Tokoro0917/Mice-Standard/mechanical/README.md

# mechanical

Fusion 360 で設計した機構データです。

| ディレクトリ | 内容 |
| --- | --- |
| `cad/` | Fusion 360 のデータ（`.f3d` / `.f3z` でエクスポート）と STEP |
| `stl/` | 3D プリント用データ（STL / 3MF）。造形設定（材料・充填率・向き）は下表に記載 |
| `dxf/` | 切削・レーザー加工用データ |

Fusion 360 のデータはクラウドにあるため、更新したらエクスポートしたファイルをここにコミットしてください。

## 3D プリント部品

機構部品は基本的に 3D プリンタで製作します。

- プリンタ: Bambu Lab（ノズル 0.4 mm）
- 材料: PLA
- 配布形式: STL と、造形設定込みの Bambu Studio 用 3MF
- 1 部品は 180 × 180 × 180 mm 以内（A1 mini 対応）

| 部品 | ファイル | 材料 | 個数 | 造形の向き・メモ |
| --- | --- | --- | --- | --- |
| シャーシ | `stl/chassis.stl`（`cad/chassis.step`） | PLA | 1 | 後ろのはりの面を下にして印刷（前のはりは約 41 mm のブリッジ）。充填 30 % 以上、壁 3 周以上 |
| ホイール | TBD | PLA | 2 | 直径 47 mm（O リング込み、車高 2.5 mm） |
| タイヤ | — | O リング / シリコン（市販品） | 2 | ホイールの溝に装着 |
| 接地点 | — | カグスベール（市販品） | 2 | φ8 に切ってシャーシの台に貼る |

## 機体全体の STEP（v0.1、Fusion 360 への読み込み用）

`cad/mice-standard-assembly.step`: シャーシ・メイン基板・センサ基板 ×4・モータ ×2・ホイール ×2 を組み立てた参考モデル（`cad/assembly-iso.png`、`cad/assembly-rear.png`、`cad/assembly-bottom.png`）。

| 項目 | 値 |
| --- | --- |
| 座標 | X = 右、Y = 前、Z = 上。原点は車軸の真下の床 |
| 全体の大きさ | 幅 80 mm（車幅、メイン基板と横センサの LED の先）× 長さ 約 128 mm × 高さ 約 69 mm |
| 電池 | Zeee 3S 850 mAh 100C（67 × 30 × 18.5 mm、74 g）を後ろに立てて載せる（長い辺を左右、高さ 30 mm） |
| その場旋回の半径 | 約 76 mm（車軸の中心から一番遠い角まで。区画の中心から壁までは 84 mm） |
| 重心（見積もり） | 全体 約 395 g、車軸の約 10 mm 後ろ、床から約 27 mm（重さは仮の値） |
| 車高 | 2.5 mm（床からモータの底面まで） |
| ホイール | 直径 47 mm（O リング込み）、幅 6 mm、モータ軸の先端に付ける（仮） |
| モータ | PKP242D23A2（42 mm 角 × 17 mm、インロー φ22、軸 φ5 × 15 mm）を背中合わせ、すき間 1 mm |
| メイン基板 | 下面の高さ 48.5 mm（モータ上面との間 4 mm。部品の足のはみ出し用） |
| センサ基板 | メイン基板の下に垂れ下がる。差し込み部はメイン基板の上に 0.9 mm 出る。下端は床から約 18.5 mm |
| NUCLEO・MP6500 | 外形だけの仮の板（ピンソケットの上、高さ 8.5 mm） |

- 色付きの図（迷路の区画 180 mm の中に置いたところ）: `cad/render-iso.png`（前・左から）、`cad/render-rear.png`（後ろから）、`cad/render-top.png`（上から）、`cad/render-side.png`（横から）
- まだ入っていないもの: ねじ、電池のバンド
- 重心が車軸より後ろなので、後ろの接地点（電池の台の下のカグスベール）にいつも少し重さがかかる（約 2 割の見込み）。気になる場合は、基板に対してモータ（車軸）を後ろへずらす
- 作り直し方: 基板の STEP（`hardware/*/` の `.step`）を同じフォルダに `main.step`・`sensor.step` として置き、CadQuery で `python make_assembly.py <フォルダ> <出力.step>`。メイン基板の STEP は原点を車軸の真上（基板の x = 40 mm、y = 55 mm）にして出力する

## シャーシ v0.1（3D プリント、PLA 一体成形）

`cad/make_chassis.py`（CadQuery）で作成。`cad/chassis.step`（Fusion 360 用）、`stl/chassis.stl`（印刷用）、`cad/chassis-iso.png`。

| 部分 | 形 |
| --- | --- |
| モータ取付壁 ×2 | 厚さ 3 mm。モータの取付面に当て、インロー φ22 の穴（φ22.4）と M3 の穴 ×2（外側に座ぐり）で留める |
| 前後のはり | 左右の壁をつなぐ。上端は基板の 10 mm 下（部品の足をよける）。真ん中を肉抜きして配線を通す |
| ボス ×4 | メイン基板の取付穴 H1〜H4 の位置。M3 タッピングねじ用の下穴 φ2.6、深さ 10 mm |
| 前の腕と接地点 | 前のはりから伸ばした腕（幅 10 mm、上面は床から 9 mm でセンサ基板の下）。先の台（φ10）の下面にカグスベールを貼る。車軸の前 45 mm |
| 電池の台（後ろ） | 後ろのはりの後ろに、電池を**立てて**載せる台。床 1.5 mm、後ろの壁 高さ 20 mm、左右の壁 高さ 6 mm（線が出る側をふさがない）。床に面ファスナーのバンドを通す穴 ×2。床の下面にカグスベールを貼って後ろの接地点にする |

- 大きさ 72 × 117 × 47 mm、体積 約 33 cm³（充填 100 % で約 41 g）
- **下面はすべて床から 2.0 mm の平らな面**（印刷のベッド面）。カグスベール（1.5 mm）を貼る面も同じで、床とのすき間 0.5 mm。モータの底面は 2.5 mm
- **印刷は下面をベッドに置いて、そのまま立てて印刷**できる（はり・腕・電池の台・ボスはすべて下面から立ち上がる）
- 組み立てに使うねじ: モータ用 M3 × 6 低頭ねじ ×4、基板用 M3 タッピングねじ（長さ 8 mm 程度）×4
- **モータの向き**: モータのコネクタ（側面から 9 mm 出る）は**後ろ向き**にする。上向きだとメイン基板に当たる。M3 の穴の位置（対角のどちらか）は現物で確認して `MOTOR_HOLES` を合わせる
- **カグスベール**（ニチアス、フリーサイズ、厚さ 約 1.5 mm、KOGUMA-Mk4 と同じ）を φ8 に切って台の下面に貼る。床とのすき間は 約 0.5 mm。厚さは実物を測って `KAGU_T` を合わせる
- 要確認: 印刷して、インローと穴のはめ合い、接地点の高さ、全体の剛性を確かめる
