Tokoro0917/Mice-Standard/hardware/production/README.md

# production

基板発注用のデータと部品表（BOM）を置きます。

- [`bom.csv`](bom.csv) : 部品表（v0.1）
- `gerber/` : ガーバーデータ（設計後に追加）

## 部品表 v0.1 の概要

- 価格は 2026-11-09 時点の秋月電子通商・RobotShop の Web サイトの表示
- 「1 台あたり」はパック品を 1 個あたりに割った値。実際の購入はパック単位
- 部品は秋月で手に入るものの中で最も性能のよいものを選ぶ
- 部品の種類はできるだけ減らす（電子部品は 21 種類。抵抗 4 種類、コンデンサ 2 種類）
- 状態: **確定** / **要確認**（品番や在庫に確認が必要） / **未定**

### 1 台あたりの費用（概算）

| 項目 | 金額 |
| --- | --- |
| NUCLEO-L432KC | 2,800 円 |
| MP6500 デジタル電流制御版 ×2（RobotShop、送料別） | 3,914 円 |
| その他の電子部品（秋月） | 約 1,000 円 |
| モータ ×2 | 0 円（提供品） |
| **電子部品の合計** | **約 7,700 円** |
| 未定: LiPo 電池、基板、PLA、O リング、ねじ、ヒートシンク | — |

### 要確認・未定の項目

- ヒートシンク: 後で検討
- MP6500: RobotShop で取り寄せ（入荷待ち）。送料・税の扱いを確認する
- LiPo 電池、O リング、ねじ、基板の費用
