Tokoro0917/Mice-Standard/docs/spec.md

# 標準機 仕様書

> ステータス: **v0.1（検討中）**
> ✅ 決定　📝 案（未確定）　❓ 未定

## 設計方針

- 競技: **クラシック**（18 cm 区画）
- 対象: **プログラム初心者**。迷路を完走するまでを標準で用意する
- 製作: 基板はサークルで発注し、部員は**はんだ付けから**
- **表面実装部品（SMD）は使わない**。部品はリード部品（スルーホール）と、ピンヘッダで差し込むモジュールのみ
- 壊れやすい部品（マイコン・モータドライバ）は**差し替え可能**にする
- NUCLEO の改造は **SB16 / SB18 を外すことのみ**（表示 LED 用）
- 機構部品は**基本的に 3D プリンタで製作**する（データは `mechanical/` で公開）

## 構成部品

| 項目 | 部品 | 数量 | 状態 | 備考 |
| --- | --- | --- | --- | --- |
| モータ | オリエンタルモーター **PKP242D23A2**（ステッピングモータ、42 mm 角、バイポーラ） | 2 | ✅ | 詳細仕様は下表。ケーブル先端は XH コネクタ（メイン基板に XH 4P ポスト） |
| モータドライバ | Pololu **MP6500** キャリア（**デジタル電流制御版**、#2968） | 2 | ✅ | STEP/DIR 制御。モータ電源 4.5〜35 V、電流制限は I1 / I2 ピンで 0.5 / 1 / 1.5 / 2 A。RobotShop で購入。ヒートシンクは後で検討 |
| マイコン | NUCLEO-L432KC（STM32L432KC、Cortex-M4 80 MHz、Flash 256 KB、RAM 64 KB） | 1 | ✅ | サークルで使用実績あり。ST-LINK と USB シリアル付き。メイン基板のピンソケットに差し込み。秋月電子で購入可（2,800 円） |
| 駆動方式 | モータ軸にホイール直結（ギアなし） | — | 📝 | |
| 車輪 | 2 輪 + 前後の接地点（カグスベール） | — | ✅ | 詳細は「機構」を参照 |
| 壁センサ | 赤外 LED OSI5LA5A33A-B（秋月 113204）+ フォトトランジスタ L-51ROPT1D1（秋月 104211） | 4 組 | ✅ | 左右横 2 組 + 前 2 組。**センサ基板に実装**（下記） |
| ジャイロ (IMU) | なし | — | 📝 | 後付けする場合は I2C1（PA9 / PA10）を使う（[ピン割り当て](pin-assignment.md)） |
| 電池 | **Zeee Premium 3S 11.1 V 850 mAh 100C**（XT30、JST-XH バランス、67 × 30 × 18.5 mm、74 g） | 1 | ✅ | 約 2 A で約 25 分。機体の後ろに立てて載せる。XT30 のオス・メスは現物で確認して基板側を合わせる |
| 電源 | P-ch MOSFET 2SJ673-AZ（電源スイッチ、KOGUMA-Mk4 と同じ方式）、スライドスイッチ、9 V LDO BA90DD0T | 1 | ✅ | **電池電圧を直接使うのはモータのみ**。9 V は NUCLEO の VIN・赤外 LED・ブザー用。ロジック系は NUCLEO の 3.3 V。詳細は「電源構成」 |
| 操作・表示 | タクトスイッチ ×2、LED ×4、ブザー | — | ✅ | LED3 / LED4 のため NUCLEO の SB16 / SB18 を外す（[ピン割り当て](pin-assignment.md)） |
| 通信 | USB シリアル（NUCLEO 内蔵） | — | 📝 | ログ取り出し用 |

## モータ PKP242D23A2 の仕様

出典: オリエンタルモーター 製品ページ（2026-11-09 時点）

| 項目 | 値 |
| --- | --- |
| タイプ | 2 相、**薄型**、バイポーラ 4 本リード、片軸 |
| 取付角寸法 | 42 mm |
| 本体長さ（取付面から後端） | 17 mm |
| 励磁最大静止トルク | 0.1 N·m |
| ローター慣性モーメント | 13 × 10⁻⁷ kg·m² |
| 基本ステップ角 | 1.8°（200 ステップ/回転） |
| 定格電流 | 2.3 A/相 |
| 電圧 | 1.4 V |
| 巻線抵抗 | 0.61 Ω/相 |
| インダクタンス | 0.53 mH/相 |
| 質量 | 0.11 kg |
| 出力軸 | φ5 mm (h7)、取付面からの長さ 15 mm、D カット（幅 4.5 mm、長さ 10 mm） |
| インロー | φ22 mm (h7)、高さ 1.5 mm |
| 取付ねじ | M3 × 2 箇所（ピッチ 31 mm、深さ 4.5 mm） |
| コネクタ | 側面から約 9 mm 突出（接続ケーブル取付時）。ハウジング MDF97A-5S-3.5C（ヒロセ電機） |
| 価格 | 定価 6,000 円/個（**サークルでは提供品を使うため費用なし**） |

### 設計上の注意

- **コネクタが側面に 9 mm 出る**ため、下向きにすると床に当たる。モータは**コネクタが上向き**になる向きで取り付ける
- 取付ねじは 2 箇所（対角）のみ。シャーシ側は M3 ねじで固定し、インロー φ22 で位置決めする
- ホイールは軸の D カットに合わせた穴にして空転を防ぐ
- **脱調防止のため、定格 2.3 A に近い電流で駆動する**。MP6500 デジタル電流制御版の最大設定 **2 A** を使う。実機で発熱を確認する（ヒートシンクは後で検討）
- 定格付近ではモータ 1 個あたり約 6.5 W の発熱（2 相励磁時の計算値）。メーカー注意事項によりモータケース温度は 100 ℃ 以下とする。**停止中は励磁を切る / 電流を下げる**制御を入れる

## 部品選定の方針と注意点

電子部品は**できるだけ秋葉原（秋月電子通商）でそろえ、秋月で手に入るものの中で最も性能のよいものを選ぶ**（ただし LDO の出力コンデンサのように、回路が安定する範囲の中で選ぶ）。抵抗は**一般的な値（E6 系列: 10, 15, 22, 33, 47, 68 × 10ⁿ）**を使い、並列・直列の組み合わせで中途半端な値を作らない。

**部品の種類はできるだけ減らす**（同じ部品を使い回す）。現在の構成:

| 種類 | 部品 | 使う場所 |
| --- | --- | --- |
| 抵抗 33 Ω 1 W | MFU100F33RB（金属皮膜） | 赤外 LED の Re |
| 抵抗 100 Ω 1/4 W | MFS25F（金属皮膜 ±1 %） | 赤外 LED 駆動トランジスタのベース |
| 抵抗 2.2 kΩ 1/4 W | MFS25F（金属皮膜 ±1 %） | 受光 RL、MP6500 SLEEP プルアップ、表示 LED、電池電圧の分圧（下側）、ブザー |
| 抵抗 10 kΩ 1/4 W | MFS25F（金属皮膜 ±1 %） | 電池電圧の分圧（上側）、電源スイッチのゲート ×2 |
| 電解コンデンサ 100 µF 25 V | Rubycon PX | MP6500 の VMOT ×2、LDO の入力・出力 |
| セラミックコンデンサ 0.1 µF | X7R 50 V | ADC 入力、電源スイッチのゲート |
| NPN トランジスタ | SS8050-D | 赤外 LED 駆動 ×2、ブザー駆動 |
| ピンソケット | 分割ロングピンソケット 1×42 | NUCLEO（15 ピン ×2）と MP6500（8 ピン ×4）に切って使う |

- **電池電圧**: LiPo 3 セル（満充電 12.6 V）。MP6500（4.5〜35 V）は範囲内。**10.8 V（3.6 V/セル）で走行を止めて警告**する（LiPo の過放電防止）
- **NUCLEO への給電**: 下記「電源構成」のとおり、9 V LDO で VIN に入れる ✅
- **壁センサの外乱光**: L-51ROPT1D1 には可視光カットの記載がないため、ファームウェアで **LED 消灯時と点灯時の差分**を測って外乱光を打ち消す
- **赤外 LED の駆動**: +9 V から定電流回路で約 80 mA（連続定格以内）。詳細は「赤外 LED の駆動回路」
- 秋月で手に入らないもの: モータドライバ MP6500（通販）、LiPo 電池（ホビーショップ・通販）、O リング・ねじ（ホームセンター・通販）

## 電源構成

```
LiPo 3 セル (10.8〜12.6 V)
  └─ XT30 ─ P-ch MOSFET（電源スイッチ、ゆっくり ON）─ +BATT
       ├─ MP6500 ×2 の VMOT（近くに電解コンデンサ）  ← 電池電圧を直接使うのはモータのみ
       ├─ 電池電圧の分圧 → ADC（VBAT_SENSE）（測定のみ）
       └─ 9 V LDO（BA90DD0T）→ +9V
              ├─ NUCLEO の VIN → NUCLEO 内蔵レギュレータ → +3V3
              │                    └─ ロジック系: プルアップ抵抗、フォトトランジスタなど（最大 500 mA）
              ├─ 赤外 LED の駆動回路（トランジスタでパルス点灯）
              └─ ブザーの駆動回路
```

- **ロジック系は NUCLEO の 3.3 V に統一**する（マイコンと同じ電源にして、ADC の基準とずれないようにするため）
- **VIN に 9 V を入れる**: VIN の範囲 7〜12 V の中ほど。電池の電圧（10.8〜12.6 V）に関係なく安定した電圧になる。VIN から入れるので ST-LINK にも給電され、NUCLEO の SB9 を外す改造は不要
- **9 V LDO BA90DD0T**（ROHM、データシートより）: 出力 9 V ±1 %、最大 2 A、最小入出力差 0.3 V（標準）/ 0.5 V（最大）@ 1 A、待機電流 0.9 mA、入力最大 25 V（秋月）、TO220FP-3（1: Vcc、2: GND、3: OUT）、過電流・過熱保護あり。電池下限 10.8 V でも 9 V を保てる。同シリーズの BA09CC0T（±2 %、1 A）より高性能なため採用
- **+9V の負荷**: NUCLEO 約 0.1 A、赤外 LED（点灯時 80 mA、平均 約 16 mA）、ブザー。BA90DD0T の 2 A に十分余裕あり
- **LDO の発熱**: (12.6 V − 9 V) × 約 0.13 A ≒ 0.45 W。許容損失 2 W（単体）以内
- **LDO のコンデンサ**: 入力・出力とも 100 µF / 25 V アルミ電解コンデンサ（Rubycon PX、MP6500 用と共通）。データシートは出力に ESR が適切なタンタル / 電解コンデンサと、負荷変動がある場合は大きな容量を推奨。**ESR は大きすぎても小さすぎても発振する**（データシート Fig.33・34）ため、ESR が極端に小さい導電性高分子（OS-CON など）や超低 ESR 品（Rubycon ZLH など）は使わず、一般品の PX を使う。試作機で発振しないか確認する
- **5 V 系は使わない**: MP6500 はロジック電源不要、赤外 LED とブザーは 9 V で駆動するため

### 電源スイッチ（P-ch MOSFET、KOGUMA-Mk4 と同じ方式）

```
電池+ ─ S ┐      ┌ D ─ +BATT
          2SJ673-AZ
            G ─┬─ R 10 kΩ ─ S
               ├─ C 0.1 µF ─ S
               └─ R 10 kΩ ─ スライドスイッチ ─ GND
```

- **大電流をスイッチに流さない**: スライドスイッチはゲートを動かすだけ。電流の経路は MOSFET（最大 20 mΩ）だけになり、経路の抵抗が小さい（KOGUMA.Mk3 の反省: 電池〜配線の抵抗 0.64 Ω、KOGUMA-Mk4 `docs/spec.md`「電源(3S)」）
- **ON**: スイッチでゲートを 10 kΩ 経由で GND に落とす。VGS = −VBAT × 10/(10+10) = −5.4 V（10.8 V）〜 −6.3 V（12.6 V）。2SJ673 は −4 V で最大 31 mΩ、しきい値 −1.5〜−2.5 V なので十分 ON
- **ゆっくり ON にする**: C 0.1 µF ×（10 kΩ ∥ 10 kΩ）で約 0.5 ms。速く ON にすると配線のインダクタンスとコンデンサで電圧が跳ねることがある（KOGUMA-Mk4 の検討）。OFF は 10 kΩ × 0.1 µF で約 1 ms
- **抵抗・コンデンサは既存の種類（10 kΩ、0.1 µF）を使う**
- **逆接続保護はない**（KOGUMA-Mk4 と同じ）: 電池を逆につなぐと MOSFET の内部ダイオードを通って回路に逆電圧がかかる。XT30 は逆に挿せない形なので、**電池のケーブルに XT30 をはんだ付けするときの極性を必ず確認する**（手順書に書く）
- **ヒューズはない**（KOGUMA-Mk4 と同じ）
- モータを回したまま電源を切らない（OFF の間、MOSFET が半分 ON になって熱を持つ）

### USB をつなぐときの手順（UM1956 7.4.2）

| 場面 | 手順 | 動くもの |
| --- | --- | --- |
| 書き込みだけ | 電池スイッチ OFF のまま USB を挿す | マイコンのみ（モータ・赤外 LED は動かない） |
| 走らせながら USB をつなぐ | **① 電池スイッチ ON → ② NUCLEO の赤 LED（LD2）点灯を確認 → ③ USB を挿す** | すべて |

- 順番を逆にすると、PC が電流を制限したり、USB の接続に失敗して NUCLEO に電源が入らなかったりすることがある（UM1956）
- ファームウェアは起動直後に STEP / DIR を L にし、**電池電圧を確認してからモータを動かす**（USB 給電のみのとき、電源の入っていない MP6500 に信号を入れ続けないため）

## 赤外 LED の駆動回路

### LED の定格（OSI5LA5A33A-B データシートより）

| 項目 | 値 |
| --- | --- |
| 順電流（連続） | 最大 100 mA |
| パルス順電流 | 最大 1,000 mA（パルス幅 10 ms 以下、デューティ 1/10 以下） |
| 順電圧 | 1.6 V（標準）/ 1.8 V（最大）@ 100 mA |
| 放射強度 | 100 mW/sr（標準）@ 100 mA |
| 許容損失 | 180 mW |

### 回路（📝 案）

グループごと（横 2 個 / 前 2 個）に、LED 2 個を直列にして **NPN トランジスタの定電流回路**で光らせる。

```
+9V
  │
 LED ─ LED（2 個直列。各センサ基板の LED をメイン基板上で直列につなぐ）
  │
  C
GPIO ── Rb 100 Ω ── B   NPN トランジスタ SS8050-D
  E
  │
 Re 33 Ω (1 W)
  │
 GND
```

| 部品 | 値 | 秋月 | 理由 |
| --- | --- | --- | --- |
| トランジスタ | SS8050-D（NPN、Ic 1.5 A、Pc 1 W、Vceo 25 V） | 130382（20 個 110 円） | 損失に余裕がある。**ピン配置は 2SC1815 と違うので要確認** |
| Re（エミッタ抵抗） | 33 Ω、1 W | 108811 | LED 電流を決める |
| Rb（ベース抵抗） | 100 Ω | 108522 | |

- **LED 電流 ≒ (3.3 V − 0.7 V) / 33 Ω ≒ 80 mA**。抵抗は**一般的な値（E6 系列）だけを使う**方針で 33 Ω とした。放射強度は 100 mA 時の約 8 割の見込み。マイコンの 3.3 V 出力で決まるので、**電池電圧が変わっても明るさが変わらない**（センサ値が電池残量でずれない）
- 電流は**連続定格 100 mA 以内**にする。ファームウェアが止まって LED が点きっぱなしになっても壊れない
- **+9V から駆動する**: 9 V − LED 2 個（最大 3.6 V）− Re 2.6 V でトランジスタに約 2.8 V 残り、定電流を保てる。電池電圧から駆動したときに必要だった直列抵抗 Rc（発熱の分担用）は不要
- 点きっぱなしのときの発熱（計算値）: トランジスタ 最大約 0.26 W（許容 1 W）、Re 0.21 W（定格 1 W）。いずれも定格内

### 点灯タイミング（📝 案）

フォトトランジスタの応答時間（立ち上がり 15 µs）を考え、1 回の測定を次の順で行う。

1. 全 LED 消灯で 4 チャンネルを読む（外乱光）
2. 横 LED を約 100 µs 点灯 → 左横・右横を読む → 消灯
3. 前 LED を約 100 µs 点灯 → 左前・右前を読む → 消灯
4. 「点灯時 − 消灯時」を壁センサの値とする

1 ms 周期なら各グループの点灯は 10 % 程度で、平均電流は約 10 mA。

## 受光回路（フォトトランジスタ）

### フォトトランジスタの定格（L-51ROPT1D1 データシートより）

| 項目 | 値 | 条件 |
| --- | --- | --- |
| 光電流 Ic | 2 mA（標準） | Vce = 5 V、放射照度 0.1 mW/cm² |
| 暗電流 | 最大 100 nA | Vce = 10 V、暗所 |
| 飽和電圧 Vce(sat) | 最大 0.4 V | Ic = 2 mA |
| 立ち上がり / 立ち下がり時間 | 15 µs / 15 µs | Vce = 5 V、Ic = 1 mA、**RL = 1 kΩ** |
| 許容損失 | 10 mW | |
| 耐圧 Vceo | 30 V | |
| ピーク感度波長 | 940 nm | LED と一致 |

### 部品の選定

秋月の赤外フォトトランジスタ（スルーホール）は L-51ROPT1D1、L-31ROPT1C（3 mm 版）、S2829（浜松ホトニクス）の 3 種類。S2829 は応答が速く（2 µs）可視光カット樹脂だが、感度が大きく低い（1.8 mA @ 1,000 lx、ピーク 800 nm）ため、**感度が最も高い L-51ROPT1D1 を採用**する。赤外 LED も秋月で放射強度が最も高い OSI5LA5A33A-B（100 mW/sr）を採用。

### 回路（📝 案）

エミッタ側に負荷抵抗を入れる**エミッタフォロワ**型。光が強いほど出力電圧が上がる。

```
3.3 V（NUCLEO の +3V3）
  │
  C
 フォトトランジスタ（センサ基板）
  E
  ├──────→ ADC（SENS_xx）
 RL 2.2 kΩ（メイン基板）
  │
 GND
```

- **出力電圧 = 光電流 × RL**。0〜約 3 V の範囲で光の量に比例する
- **RL = 2.2 kΩ** ✅（光電流 約 1.4 mA で出力が上限 約 3 V に達する）
  - 感度を優先して 1 kΩ より大きくした。代わりに応答が遅くなる（データシートの 15 µs は RL = 1 kΩ の条件）ため、**LED の点灯時間を約 100 µs に延ばす**
  - 試作機で、壁にいちばん近づいたときに値が上限に張り付かないか確認する。張り付く場合は 1 kΩ に下げる
- 個体差（LED の明るさ、取り付け角度）は**ファームウェアの校正**で補正する。半固定抵抗は使わない（調整の手間とばらつきを避ける）
- コンデンサは入れない（応答が遅くなるため）
- 許容損失の確認: 最悪でも約 1.2 mW（Vce 1.65 V × 0.75 mA）で 10 mW 以内

### センサ基板の接続

各センサ基板とメイン基板の接続は **4 本**: LED アノード、LED カソード、フォトトランジスタのコレクタ（3.3 V）、エミッタ（RL と ADC へ）。センサ基板には LED とフォトトランジスタの 2 部品だけを載せる。

## メイン基板のその他の回路（📝 案）

### 電源まわり

```
LiPo 3 セル ─ XT30 ─ P-ch MOSFET（電源スイッチ）──────────────┬─ VMOT ×2（各 100 µF / 25 V 電解コンデンサ）
                                                              ├─ 分圧回路 → VBAT_SENSE
                                                              └─ 9 V LDO BA90DD0T → +9V（NUCLEO VIN、赤外 LED、ブザー）
```

| 部品 | 案 | 理由 |
| --- | --- | --- |
| 電源スイッチ | P-ch MOSFET 2SJ673-AZ + スライドスイッチ SS-12D00G3 + 10 kΩ ×2 + 0.1 µF | 大電流はスイッチに流さない（「電源スイッチ」参照）。ヒューズ・逆接続保護はなし |
| 9 V LDO | BA90DD0T + 100 µF / 25 V ×2 | +9V（NUCLEO の VIN、赤外 LED、ブザー） |
| 電解コンデンサ | 100 µF / 25 V ×2（各 MP6500 の近く） | Pololu の推奨（47 µF 以上）。電圧スパイク対策 |
| 電池コネクタ | XT30 | 逆挿しできない形のもの |

### 電池電圧の分圧回路

```
電池（スイッチ後）─ 10 kΩ ─┬─→ ADC（VBAT_SENSE, PA7）
                           ├─ 0.1 µF ─ GND
                          2.2 kΩ
                           │
                          GND
```

- 分圧比 2.2 / 12.2。満充電 12.6 V → 2.27 V（ADC 上限 3.3 V 以内）。部品の種類を減らすため 2.2 kΩ と 10 kΩ の組み合わせにした
- 分解能: 約 4.4 mV/LSB（12 ビット）。下限 10.8 V の判定に十分
- 消費電流 約 1 mA（スイッチ OFF 時は流れない）
- 0.1 µF は ADC の読み取りを安定させるため

### スイッチ

```
GPIO（SW1: PB4 / SW2: PA10）─ タクトスイッチ ─ GND
```

- マイコン内蔵のプルアップを使う（押すと L）
- チャタリングはファームウェアで除去する

### 表示 LED

```
GPIO（LED1: PB3 / LED2: PA9 / LED3: PB7 / LED4: PB6）─ 2.2 kΩ ─ LED ─ GND
```

- 約 0.6 mA（赤 LED、Vf 約 2 V の場合）。20,000 mcd の高輝度 LED なので十分見える見込み（部品の種類を減らすため 2.2 kΩ）
- LED1 は NUCLEO 上の LD3 と同時に光る

### ブザー

```
+9V ─┬─ 圧電サウンダ（他励式）─┬─ C
     └─ 2.2 kΩ ─────────────────┘   SS8050-D
GPIO（BUZZER: PA6, TIM16 PWM）─ 2.2 kΩ ─ B
                                     E ─ GND
```

- **+9V で鳴らす**（圧電サウンダの最大 30 Vp-p 以内）。3.3 V で直接鳴らすより音が大きい
- 2.2 kΩ（サウンダと並列）はトランジスタ OFF 時にサウンダの電荷を逃がす
- トランジスタ・抵抗は赤外 LED 駆動などと同じ部品
- PWM の周波数で音の高さを変えられる（音階で走行モードを知らせる）

## モータドライバ（MP6500）の接続

**MP6500 専用**で設計する ✅。Pololu MP6500 キャリア（**デジタル電流制御版 #2968**）をメイン基板のピンソケット（8 ピン × 2 列、2.54 mm ピッチ）に差し込む。

| ピン | 機能（Pololu 製品ページより） | メイン基板側の接続（案） |
| --- | --- | --- |
| ENBL | H で出力停止（未接続で有効） | マイコン GPIO（**停止中の励磁オフ**に使う） |
| MS1, MS2 | マイクロステップ設定（L/L=フル、H/L=1/2、L/H=1/4、H/H=1/8） | **3.3 V に固定して 1/8**（GPIO を節約） |
| I1, I2 | 電流制限の設定（Z/Z = 0.5 A、L/Z = 1 A、Z/L = 1.5 A、L/L = 2 A。Z は未接続） | **両方 GND に接続して 2 A 固定** 📝 |
| SLEEP | H で動作（内部 500 kΩ プルダウン） | 2.2 kΩ で 3.3 V にプルアップ（Pololu 推奨は 4.7 kΩ 以下） |
| STEP | ステップ入力 | マイコン（タイマ出力） |
| DIR | 回転方向 | マイコン GPIO |
| VMOT, GND | モータ電源 4.5〜35 V | 電池（電源スイッチ後）。近くに電解コンデンサを置く |
| A1, A2, B1, B2 | モータ出力 | モータのコネクタ |
| FAULT | 異常時 L（オープンドレイン、1.5 kΩ 直列） | 未接続（ピンに余裕があればマイコン入力） |

- 電流制限: I1 / I2 を GND に固定して **2 A**（Pololu 製品ページ #2968 の表による）。ポテンショメータの調整は不要
- 将来、停止中に電流を下げたい場合は、I2 を L のまま I1 を PWM で制御できる（電流 = 2 A − 0.58 A/V × I1 の電圧）。ただしマイコンのピンが 1 本必要
- ロジック電源は不要（内蔵レギュレータ）。3.3 V ロジックで直接駆動できる
- **ピンの物理的な並び（確認済み ✅）**: Pololu の配線図（#2968 の「Basic wiring diagram」）と裏面の写真で確認した。部品面（上）から見て:

  | 位置 | 左列 | 右列 |
  | --- | --- | --- |
  | 1 | ENBL | VMOT |
  | 2 | MS1 | GND |
  | 3 | MS2 | B2 |
  | 4 | I1 | B1 |
  | 5 | I2 | A1 |
  | 6 | SLEEP | A2 |
  | 7 | STEP | FAULT |
  | 8 | DIR | GND |

  - 基板の大きさは 0.6 × 0.8 インチ（15.2 × 20.3 mm）、ピンは 0.1 インチ（2.54 mm）間隔の 8 ピン × 2 列
  - モータの巻線は B2・B1 が 1 組、A1・A2 が 1 組
  - Pololu の配線図でも VMOT に 100 µF を付けている（標準機と同じ）
  - 裏面の印刷は左右が反対（VMOT が左上）。基板のフットプリントを作るときは上から見た並びで作る
- 注意（Pololu）: 長い電源線と低 ESR コンデンサの組み合わせで生じる電圧スパイクでボードが壊れることがあるため、VMOT の近くに電解コンデンサ（47 µF 以上）を置く

## 基板構成

| 基板 | 枚数/台 | 内容 | 状態 |
| --- | --- | --- | --- |
| メイン基板 | 1 | NUCLEO、モータドライバ、電源、LED 駆動回路、スイッチ・LED・ブザー | ✅ |
| センサ基板 | 4 | 赤外 LED + フォトトランジスタ 1 組ずつ | ✅ |

### センサ基板

- **センサ 1 組につき 1 枚**（左横・右横・左前・右前の 4 枚） ✅
- **メイン基板のスリット（溝）に差し込んではんだ付け**し、メイン基板に垂直に固定する ✅
- センサの向きは**メイン基板のスリットの角度で決める**。部品のリードを曲げて調整しなくてよい ✅

### 壁センサの配置（KOGUMA-Mk4 と同じ考え方）

座標は車軸から（X = 右、Y = 前）。区画の中心にいるとき、前の壁は Y 84 mm、横の壁は X ±84 mm、前の柱は Y 84〜96 mm。

| センサ | 位置 | 向き | ねらい |
| --- | --- | --- | --- |
| 前 LF / RF | (∓29, 49)。外側（ホイールの前） | 前から外へ **7°** | 前の壁に約 35 mm で当たる。左右 2 点で壁の傾きがわかる。斜めの直線で柱にかかりやすい（KOGUMA-Mk4 の検討） |
| 横 LS / RS | (∓30.5, 39)。一番外側、前センサの少し後ろ。**交差させない** | 前から外へ **44.7°**（真横から 45.3°） | 自分の側の前の柱の前半分の真ん中（X ±84, Y 93）を見る。前の壁があるときは柱の手前で前の壁に当たる |

- 角度は `hardware` の配置スクリプトで目標の点から計算している
- 横センサは、光が前センサの基板より外側を通るよう、前センサの外側・後ろに置いた。全体のモデルで、LED と受光の正面（半径 2.5 mm、80 mm 先まで）がどの部品にも遮られないことを確かめた
- 横センサの LED の先が車幅 80 mm（基板の幅）にちょうど収まる位置
- 4 枚とも**同じ設計**にし、まとめて発注する 📝
- 接合部: センサ基板の差し込み部の端と、メイン基板のスリット周囲に向かい合うパッドを設け、はんだで電気接続と固定を兼ねる 📝
- 接続する信号: LED（アノード / カソード）、フォトトランジスタ出力、電源、GND の 4〜5 本 📝
- LED を光らせるトランジスタなどの回路はメイン基板側に置き、センサ基板の部品は最小限にする 📝
- メイン基板とセンサ基板は 1 つの基板データに面付けして一緒に発注する 📝

## 機構（3D プリント）

| 部品 | 製作方法 | 材料 | 状態 | 備考 |
| --- | --- | --- | --- | --- |
| シャーシ（モータ・基板の取付台） | 3D プリント | PLA | ✅ | 一体成形（モータ取付壁 ×2、前後のはり、基板のボス ×4、前後に伸ばした腕とカグスベールの台 ×2）。詳細は `mechanical/README.md` |
| ホイール | 3D プリント | PLA | ✅ | モータ軸に圧入 + 止めねじ（案） |
| タイヤ | 市販品 | O リング / シリコンタイヤ（案） | 📝 | PLA ではグリップが出ないため。ホイール外周に溝を設けて装着 |
| 接地点 | カグスベール（ニチアス、厚さ 約 1.5 mm）を φ8 に切って、前の腕の台と電池の台の下に貼る | — | ✅ | 床とのすき間 約 0.5 mm（KOGUMA-Mk4 と同じ） |
| 遮光カバー | 3D プリント | PLA | 📝 | LED → フォトトランジスタへの直接の回り込み光を防ぐ |
| 電池ホルダ | 3D プリント | PLA | 📝 | 交換しやすい形にする |

- 3D プリンタ: **Bambu Lab** ✅（ノズル 0.4 mm 標準）
- 材料: **PLA のみ** ✅
- 造形サイズ: 1 部品を **180 × 180 × 180 mm 以内**にする（A1 mini でも印刷できるように）
- 配布形式: STL に加え、造形設定込みの **Bambu Studio 用 3MF** を `mechanical/stl/` に置く
- 締結: M3 ねじ + ナット（ねじ規格は統一する） 📝
- 公差: 部員が同じプリンタで再現できるよう、穴・圧入部の寸法は試験片で決めて仕様書に記載する

## 機体寸法・性能目標

モータ 2 個を背中合わせに配置し、軸にホイールを直結する前提での**概算**。

| 項目 | 目標 | 根拠 | 状態 |
| --- | --- | --- | --- |
| 車幅 | **80 mm** | メイン基板の幅。横センサの LED の先まで含めて 80 mm 以内 | ✅ |
| 全長 | 約 128 mm | 電池の台の後ろ（Y −66.5）から前のセンサの LED（Y 61）まで。その場旋回の半径 約 76 mm | 📝 |
| 車高 | **2.5 mm** | 床からモータの底面（最も低い部分）まで | ✅ |
| ホイール径 | **47 mm**（O リング込み） | 車高 2.5 mm + モータの半分 21 mm = 車軸の高さ 23.5 mm | ✅ |
| 重量 | 約 350〜400 g | モータ 220 g + 基板・電池・プリント部品 | 📝 |
| 探索速度 | 0.3 m/s | ホイール径 47 mm で約 122 rpm。トルク特性に十分な余裕あり | 📝 |
| 分解能 | 約 0.09 mm/ステップ | MP6500 の最大 1/8 マイクロステップ（1,600 ステップ/回転）、ホイール 1 周 約 148 mm | 📝 |

## ファームウェアで用意する機能

- 直進・90° 旋回・180° 旋回
- 壁センサの読み取りと壁の有無判定
- 迷路探索: 左手法、足立法
- 走行ログの USB シリアル出力
- 電池電圧低下の警告

## 未決定事項

- [ ] タイヤ（O リング / シリコン）の品番選定
- [ ] 部品表の要確認項目（[bom.csv](../hardware/production/bom.csv)）
- [ ] 受光回路 RL の実機確認
- [ ] モータ駆動電流の最終値と停止時の電流低減方法
- [ ] 機体寸法・重量
- [ ] 1 台あたりの予算
- [ ] 製作難易度
- [ ] 完成目標時期
