Tokoro0917/Mice-Standard/docs/pin-assignment.md

# ピン割り当て（NUCLEO-L432KC）

> ステータス: **v0.1（案）**。CubeMX で NUCLEO-L432KC を選んで設定し、矛盾がないことを確認してから確定する。

## 前提: NUCLEO-L432KC で自由に使えるピン

NUCLEO-L432KC のヘッダは Arduino Nano 配置で、入出力ピンは 22 本。ただしボード上のはんだブリッジ（SB）の初期設定により、そのまま独立に使えるのは 17 本。

標準機では **SB16 と SB18 を外して 19 本**使う（下記「NUCLEO の改造」）。

出典: ST ユーザーマニュアル **UM1956 Rev 6**（Table 6, 7, 8, 16）で確認済み ✅

| ヘッダ | STM32 ピン | 制約 | 根拠 |
| --- | --- | --- | --- |
| D7, D8 | PC14, PC15 | 32.768 kHz 水晶（LSE）用。初期状態ではヘッダにつながっていない | Table 6（STM32L は LSE が初期設定）、Table 16 注 3 |
| A7 | PA2 | ST-LINK の仮想 COM ポート（USB シリアル）送信に使用。受信は PA15（ヘッダには出ていない） | Table 7: SB2 / SB3 初期 ON、Table 16 注 6 |
| A5 と D5 | PA6 と PB6 | SB16 初期 ON で PB6 が A5 ピンにつながり、**D5 ピンは使えない**。A5 を使うときは PB6 を入力（フローティング）にする | Table 8: SB16 |
| A4 と D4 | PA5 と PB7 | SB18 初期 ON で PB7 が A4 ピンにつながり、**D4 ピンは使えない**。A4 を使うときは PB7 を入力（フローティング）にする | Table 8: SB18 |
| D13 | PB3 | ユーザー LED（LD3、緑）がつながっている | Table 8: SB15 初期 ON |

## 割り当て

| # | ヘッダ | STM32 | 機能 | 用途 | 信号名 |
| --- | --- | --- | --- | --- | --- |
| 1 | A0 | PA0 | ADC1_IN5 | 壁センサ 左横 | `SENS_LS` |
| 2 | A1 | PA1 | ADC1_IN6 | 壁センサ 左前 | `SENS_LF` |
| 3 | A2 | PA3 | ADC1_IN8 | 壁センサ 右前 | `SENS_RF` |
| 4 | A3 | PA4 | ADC1_IN9 | 壁センサ 右横 | `SENS_RS` |
| 5 | A6 | PA7 | ADC1_IN12 | 電池電圧（分圧） | `VBAT_SENSE` |
| 6 | D9 | PA8 | TIM1_CH1 | 左モータ STEP | `STEP_L` |
| 7 | A4 | PA5 | TIM2_CH1（※） | 右モータ STEP | `STEP_R` |
| 8 | A5 | PA6 | TIM16_CH1（※） | ブザー | `BUZZER` |
| 9 | D2 | PA12 | GPIO 出力 | 左モータ DIR | `DIR_L` |
| 10 | D3 | PB0 | GPIO 出力 | 右モータ DIR | `DIR_R` |
| 11 | D6 | PB1 | GPIO 出力 | 両モータ ENBL（H で出力停止） | `MOTOR_EN` |
| 12 | D10 | PA11 | GPIO 出力 | 赤外 LED 横 2 個を点灯 | `IRLED_SIDE` |
| 13 | D11 | PB5 | GPIO 出力 | 赤外 LED 前 2 個を点灯 | `IRLED_FRONT` |
| 14 | D12 | PB4 | GPIO 入力（プルアップ） | スイッチ 1 | `SW1` |
| 15 | D0 | PA10 | GPIO 入力（プルアップ） | スイッチ 2 | `SW2` |
| 16 | D13 | PB3 | GPIO 出力 | LED 1（ボード上の LD3 も同時に点灯） | `LED1` |
| 17 | D1 | PA9 | GPIO 出力 | LED 2 | `LED2` |
| 18 | D4 | PB7 | GPIO 出力 | LED 3（**SB18 を外す**） | `LED3` |
| 19 | D5 | PB6 | GPIO 出力 | LED 4（**SB16 を外す**） | `LED4` |

使わないピン: D7, D8（LSE）、A7（USB シリアル）

※ PA5 の TIM2_CH1、PA6 の TIM16_CH1 は UM1956 の表には載っていない（表はボード上の代表的な機能のみ）。STM32L432KC のデータシートまたは CubeMX で確認する。ADC チャンネル（PA0=IN5, PA1=IN6, PA3=IN8, PA4=IN9, PA7=IN12）と PA8 の TIM1_CH1 は UM1956 Table 16 で確認済み

## 設計の考え方

- **STEP は別々のタイマに割り当てる**（TIM1 / TIM2）。左右のモータを違う速さで回せるようにするため
- **両モータの ENBL は 1 本にまとめる**。止めるときは両方同時でよいため
- **赤外 LED は「横 2 個」「前 2 個」の 2 グループで点灯**する。横の 2 個は反対向きなので同時に光らせても干渉しない
- 壁センサは「LED 消灯時」と「点灯時」の差分を測る（外乱光対策）。ADC は 4 チャンネルを順番に読む
- MP6500 の MS1 / MS2 は基板上で 3.3 V に固定（1/8 ステップ）するので、マイコンのピンは使わない
- **電池電圧の分圧**: 満充電 12.6 V を 3.3 V 以下にする。例: 30 kΩ と 10 kΩ で 1/4 → 3.15 V

## NUCLEO の改造（SB16 / SB18 を外す）

表示 LED を 4 個にするため、**NUCLEO-L432KC のはんだブリッジ SB16 と SB18 を外す** ✅。

| ブリッジ | 初期状態 | 外したあと（UM1956 Table 8） |
| --- | --- | --- |
| SB16 | ON: PB6 が A5 ピンにつながり、D5 ピンは使えない | A5 ピンは PA6 のみ、**D5 ピンが PB6 として使える** |
| SB18 | ON: PB7 が A4 ピンにつながり、D4 ピンは使えない | A4 ピンは PA5 のみ、**D4 ピンが PB7 として使える** |

- 標準機で唯一の NUCLEO の改造。はんだごてとはんだ吸い取り線でブリッジのはんだを取り除く
- 手順は写真付きで `docs/soldering/` に書く
- 外し忘れると LED3 / LED4 が右モータ STEP・ブザーとつながってしまうため、**組み立て前のチェック項目**にする
- 外したあとは A4 / A5 で I2C は使えない（IMU を付けるなら PA9 / PA10 の I2C1 を使う）

## 仕様からの変更点

| 項目 | 元の案 | 変更後 | 理由 |
| --- | --- | --- | --- |
| IMU（ジャイロ）の予備 | ピンヘッダを用意 | **v1 では用意しない** | ピン不足。後で付けるなら、`SW2`（PA10）と `LED2`（PA9）を I2C1（SDA / SCL）に切り替える |

## 電源についての注意（UM1956 7.4 より）

| 入力 | 電圧 | 条件 |
| --- | --- | --- |
| VIN (CN4-1) | 7〜12 V | 入力電流は電圧で制限（10 V 超では 300 mA 未満） |
| +5V (CN4-4) | 4.75〜5.25 V、最大 500 mA | ST-LINK に給電されない。**USB をつながずに +5V だけで動かすには SB9 を外す必要がある**（ST-LINK が NRST を押さえるため） |

- 3 セル LiPo（満充電 12.6 V）は VIN の上限 12 V を超える
- 外部電源で動かしながら USB をつなぐときは、**先に外部電源を入れてから USB を挿す**

→ 9 V LDO（BA90DD0T）で作った 9 V を VIN に給電する（[仕様書](spec.md)「電源構成」）

## 要確認

- [x] UM1956 で、D7 / D8、A7、D4-A4 / D5-A5、D13 の LED の扱いを確認
- [ ] CubeMX で各ピンの機能（特に PA5 の TIM2_CH1、PA6 の TIM16_CH1）が割り当てられるか確認
- [ ] PA9 / PA10 が I2C1 に切り替えられるか確認（IMU を後付けする場合）
