Tokoro0917/Mice-Standard/tools/README.md

# tools

PC 側で使う補助ツールを置きます（走行ログの可視化、パラメータ調整など）。

TBD
