Tokoro0917/Mice-Standard/hardware/main-board/placement.png

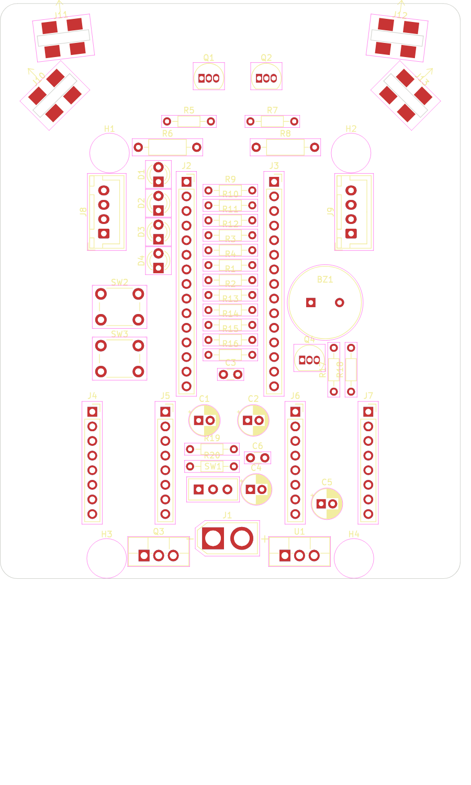
hardware/main-board/placement.png
