Tokoro0917/Mice-Standard/mechanical/cad/chassis-iso.png

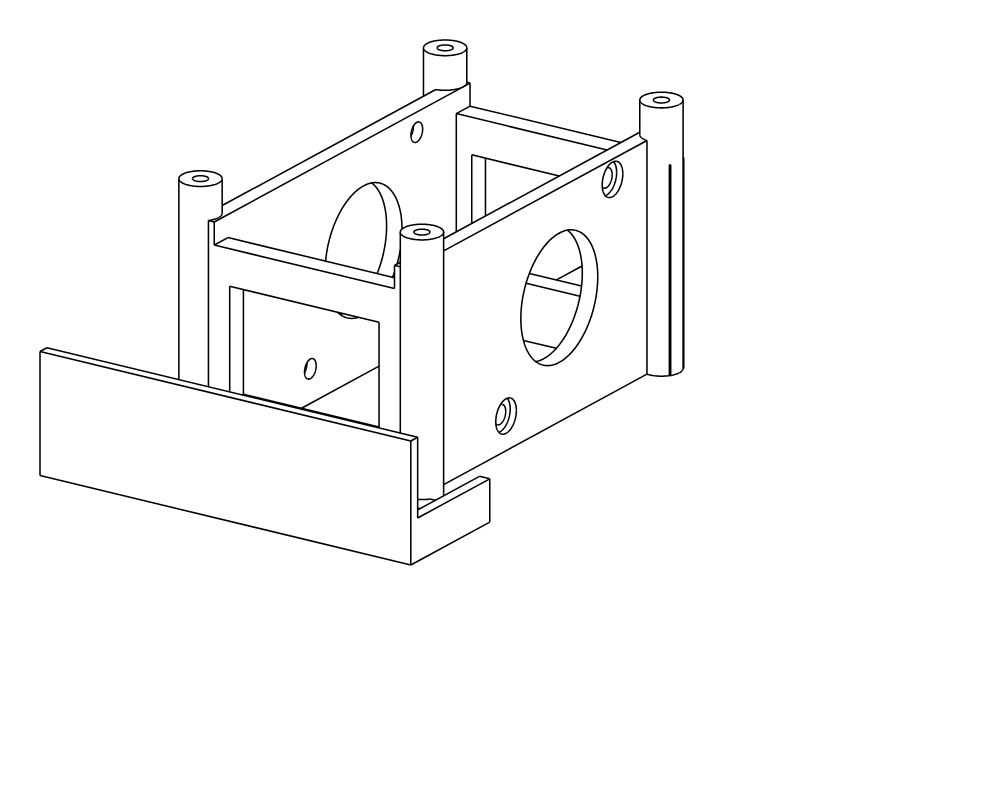
mechanical/cad/chassis-iso.png
