Tokoro0917/Mice-Standard/mechanical/cad/render-iso.png

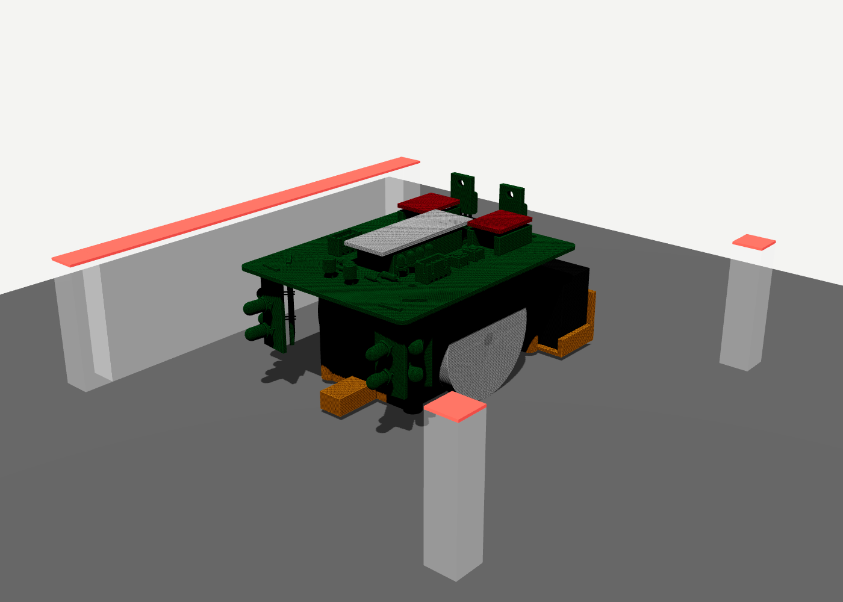
mechanical/cad/render-iso.png
