Tokoro0917/Mice-Standard/mechanical/cad/render-rear.png

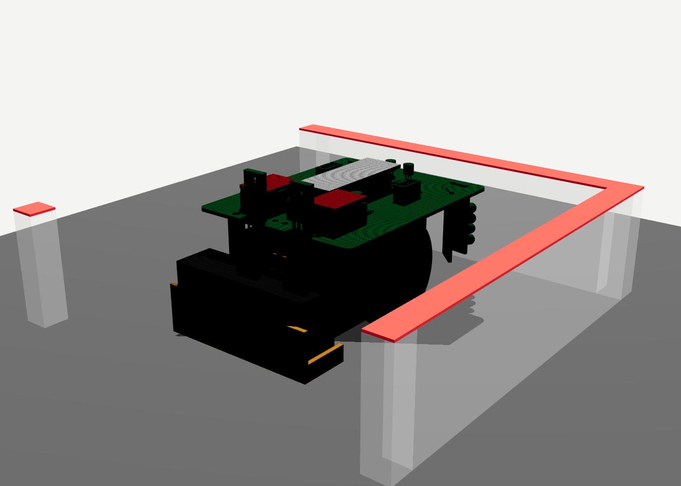
mechanical/cad/render-rear.png
