Tokoro0917/Mice-Standard/mechanical/cad/render-side.png

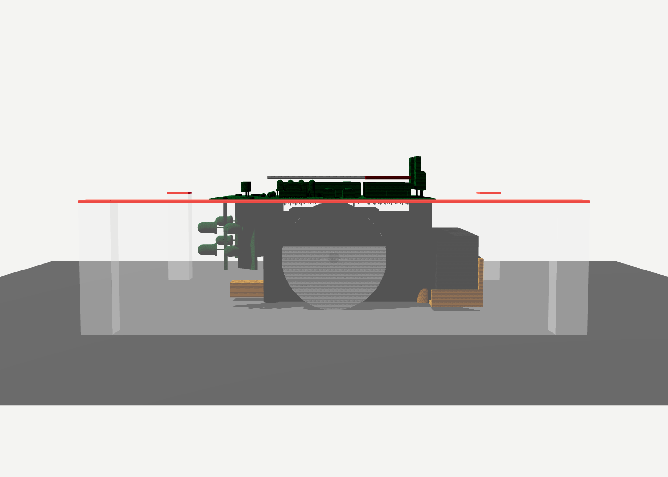
mechanical/cad/render-side.png
