Tokoro0917/Mice-Standard/mechanical/cad/render-top.png

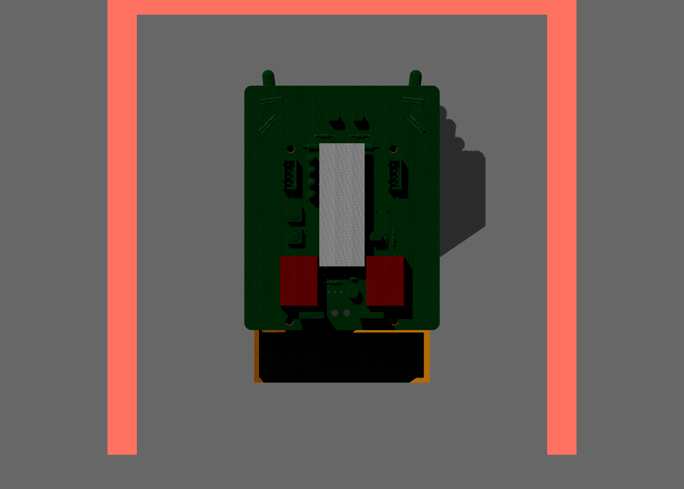
mechanical/cad/render-top.png
