Tokoro0917/Mice-Standard/hardware/production/bom.csv

区分 | 部品 | 品番 | 数量/台 | 購入先 | 販売コード | 価格(税込) | 価格の単位 | 1台あたり(円) | 用途・備考 | 状態
マイコン | NUCLEO-L432KC | NUCLEO-L432KC | 1 | 秋月電子 | 129419 | 2800 | 1個 | 2800 | SB16/SB18 を外して使う | 確定
モータ | ステッピングモータ | PKP242D23A2 | 2 | 提供品 |  | 0 |  | 0 | ケーブル先端は XH コネクタ | 確定
モータドライバ | Pololu MP6500 キャリア（デジタル電流制御版） | #2968 (RobotShop SKU RB-Pol-614) | 2 | RobotShop |  | 1957 | 1個 | 3914 | I1/I2 を GND に固定して 2 A。取り寄せ（入荷待ち）。送料・税込か未確認 | 確定
モータドライバ | ヒートシンク |  | 2 | 未定 |  |  |  |  | 後で検討 | 未定
壁センサ | 赤外 LED 5 mm 940 nm 100 mW/sr 30° | OSI5LA5A33A-B | 4 | 秋月電子 | 113204 | 20 | 1個 | 80 | センサ基板。秋月の赤外 LED で放射強度が最大 | 確定
壁センサ | フォトトランジスタ 5 mm 940 nm | L-51ROPT1D1 | 4 | 秋月電子 | 104211 | 200 | 10個 | 80 | センサ基板。秋月の赤外フォトトランジスタで感度が最大 | 確定
半導体 | NPN トランジスタ（Ic 1.5 A / Pc 1 W） | SS8050-D | 3 | 秋月電子 | 130382 | 110 | 20個 | 17 | 赤外 LED 駆動 ×2、ブザー駆動 ×1。ピン配置要確認（2SC1815 と異なる） | 確定
半導体 | P-ch MOSFET −60 V −36 A 17 mΩ（絶縁型 TO-220） | 2SJ673-AZ | 1 | 秋月電子 | 109043 | 300 | 1個 | 300 | 電源スイッチ（KOGUMA-Mk4 方式） | 確定
半導体 | 低損失レギュレータ 9 V 2 A ±1 % | BA90DD0T | 1 | 秋月電子 | 130254 | 150 | 1個 | 150 | +9V（NUCLEO VIN、赤外 LED、ブザー） | 確定
抵抗 | 金属皮膜抵抗 33 Ω 1 W | MFU100F33RB | 2 | 秋月電子 | 108811 | 300 | 100本 | 6 | 赤外 LED の Re | 確定
抵抗 | 金属皮膜抵抗 100 Ω 1/4 W ±1 % | MFS25F100RB | 2 | 秋月電子 | 108522 | 290 | 100本 | 6 | 赤外 LED 駆動トランジスタのベース | 確定
抵抗 | 金属皮膜抵抗 2.2 kΩ 1/4 W ±1 % | MFS25F2K2B | 13 | 秋月電子 | 108540 | 250 | 100本 | 33 | 受光 RL ×4、SLEEP ×2、表示 LED ×4、分圧 ×1、ブザー ×2。秋月の在庫が少ない（10 袋） | 確定
抵抗 | 金属皮膜抵抗 10 kΩ 1/4 W ±1 % | MFS25F10KB | 3 | 秋月電子 | 108550 | 300 | 100本 | 9 | 分圧 ×1、電源スイッチのゲート ×2 | 確定
コンデンサ | 電解コンデンサ 100 µF 25 V 105 ℃（Rubycon PX） | 25PX100MEFC5X11 | 4 | 秋月電子 | 117877 | 10 | 1個 | 40 | MP6500 VMOT ×2、LDO 入力・出力 ×2 | 確定
コンデンサ | 積層セラミックコンデンサ 0.1 µF 50 V X7R | R15X7R104J2L705Y | 2 | 秋月電子 | 112670 | 10 | 1個 | 20 | ADC 入力（電池電圧）、電源スイッチのゲート | 確定
電源 | スライドスイッチ 基板用 1 回路 2 接点（30 V DC / 0.3 A） | SS-12D00G3 | 1 | 秋月電子 | 115707 | 20 | 1個 | 20 | 電源スイッチ（MOSFET のゲートを切り替えるだけ） | 確定
操作・表示 | タクトスイッチ 6 mm | DTS-63-N-V-BLK | 2 | 秋月電子 | 103647 | 15 | 1個 | 30 | SW1 / SW2 | 確定
操作・表示 | 赤色 LED 3 mm 20000 mcd | OS5RKA3131A | 4 | 秋月電子 | 104767 | 270 | 10個 | 108 | LED1〜LED4。45000 mcd 品（107460）は在庫僅少のため不採用 | 確定
操作・表示 | 圧電サウンダ 13 mm（他励式） | PKM13EPYH4000-A0 | 1 | 秋月電子 | 104118 | 30 | 1個 | 30 | ブザー。+9V で駆動 | 確定
コネクタ | 分割ロングピンソケット 1×42 | FHU-1x42SG | 2 | 秋月電子 | 105779 | 80 | 1個 | 160 | NUCLEO 用 15 ピン ×2、MP6500 用 8 ピン ×4 に切って使う | 確定
コネクタ | XT30 コネクタ メス | XT30U-F | 1 | 秋月電子 | 117950 | 70 | 1個 | 70 | 電池接続 | 確定
コネクタ | XH コネクタ ベース付ポスト トップ型 4P | B4B-XH-A(LF)(SN) | 2 | 秋月電子 | 112249 | 15 | 1個 | 30 | モータ接続 | 確定
電池 | LiPo 3S 11.1 V 850 mAh 100C（XT30、JST-XH バランス、67 × 30 × 18.5 mm、74 g） | Zeee Premium Series（2 個入り） | 1 | Amazon | B08PSRWYZ1 |  | 2個 |  | 機体の後ろに立てて載せる。XT30 のオス・メスを確認して基板側（J1）を合わせる | 確定
機構 | 面ファスナーのバンド（幅 10 mm 程度） |  | 1 | 未定 |  |  |  |  | 電池を台に留める | 未定
基板 | メイン基板 + センサ基板 ×4 |  | 1 | 基板メーカー |  |  |  |  | 設計後に見積もり | 未定
機構 | PLA フィラメント |  |  |  |  |  |  |  | 3D プリント部品 | 未定
機構 | O リング（タイヤ） |  | 2 | 未定 |  |  |  |  | 品番未定（ホイール径 47 mm） | 未定
機構 | カグスベール（ニチアス、フリーサイズ、厚さ 約 1.5 mm） |  | 1 | ホームセンター・通販 |  |  |  |  | φ8 に 2 枚切ってシャーシの接地点に貼る | 未定
機構 | M3 ねじ・ナット |  |  |  |  |  |  |  | 数量は設計後 | 未定
