Tokoro0917/Mice-Standard/mechanical/cad/mice-standard-assembly.step

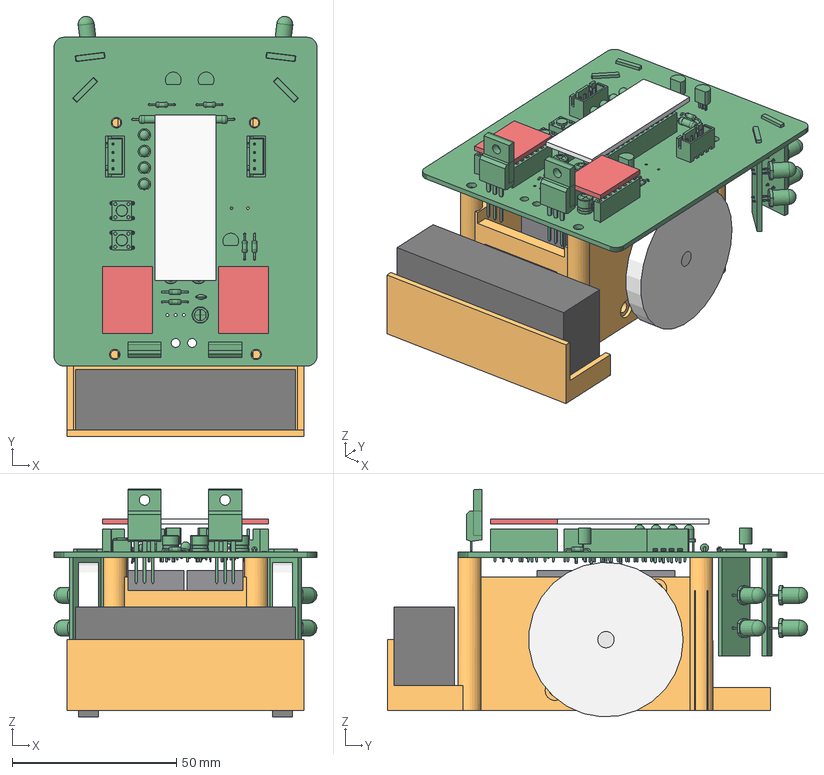
[picture p7: CAD file, 2026-11-10]
mechanical/cad/mice-standard-assembly.step
80.0 x 127.9 x 69.2 mm
main-board
chassis (PLA)
motor_L
shaft_L
wheel_L
motor_R
shaft_R
wheel_R
sensor_J11_LF
sensor_J12_RF
sensor_J10_LS
sensor_J13_RS
NUCLEO-L432KC (ä»®)
MP6500_L (ä»®)
MP6500_R (ä»®)
battery 3S 850mAh
