Tokoro0917/Mice-Standard/hardware/main-board/mice-standard.step

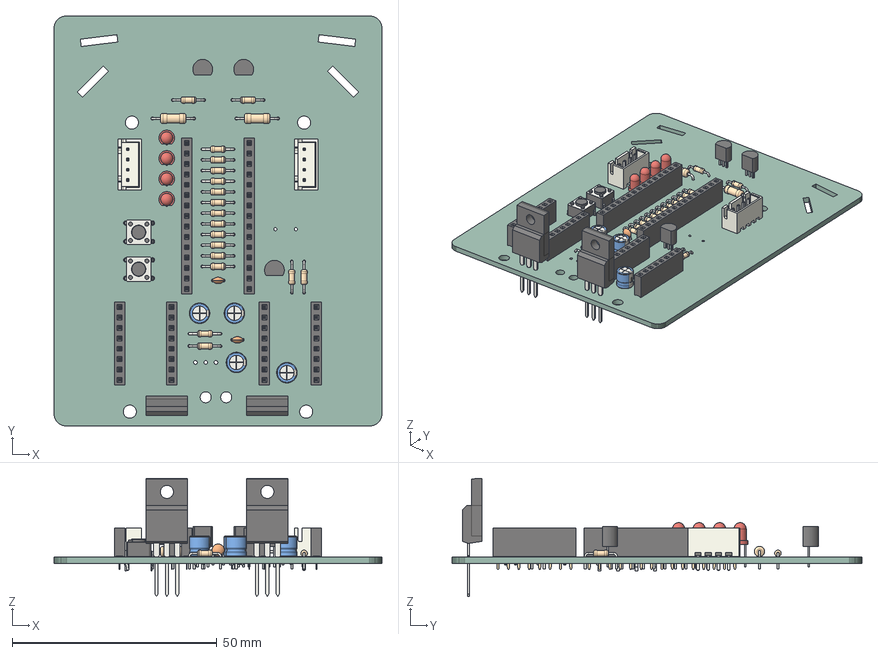
[picture p8: CAD file, 2026-11-10]
hardware/main-board/mice-standard.step
80.0 x 100.0 x 28.9 mm
R_Axial_DIN0204_L36mm_D16mm_P762mm_Horizontal x 18
JST_B4B_XH_A x 2
CP_Radial_D50mm_P200mm x 4
C_Disc_D30mm_W16mm_P250mm x 2
LED_D3.0mm x 4
PinSocket_1x08_P254mm_Vertical x 4
TO-92_Inline_Narrow x 3
TO-220F-3_Vertical x 2
R_Axial_DIN0207_L63mm_D25mm_P1016mm_Horizontal x 2
PinSocket_1x15_P254mm_Vertical x 2
SW_PUSH_6mm x 2
mice-standard PCB
