Tokoro0917/Mice-Standard/hardware/sensor-board/sensor-board.step

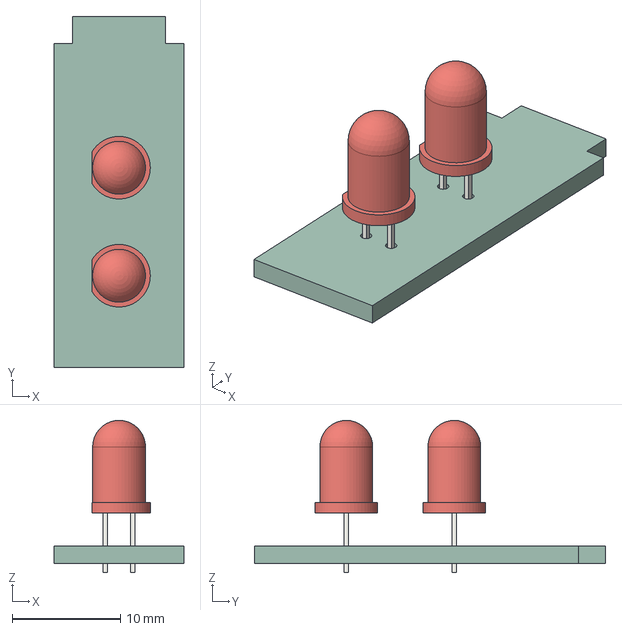
[picture p9: CAD file, 2026-11-09]
hardware/sensor-board/sensor-board.step
12.0 x 32.5 x 14.1 mm
LED_D5.0mm x 2
sensor-board PCB
