Tokoro0917/Mice-Standard/mechanical/cad/chassis.step

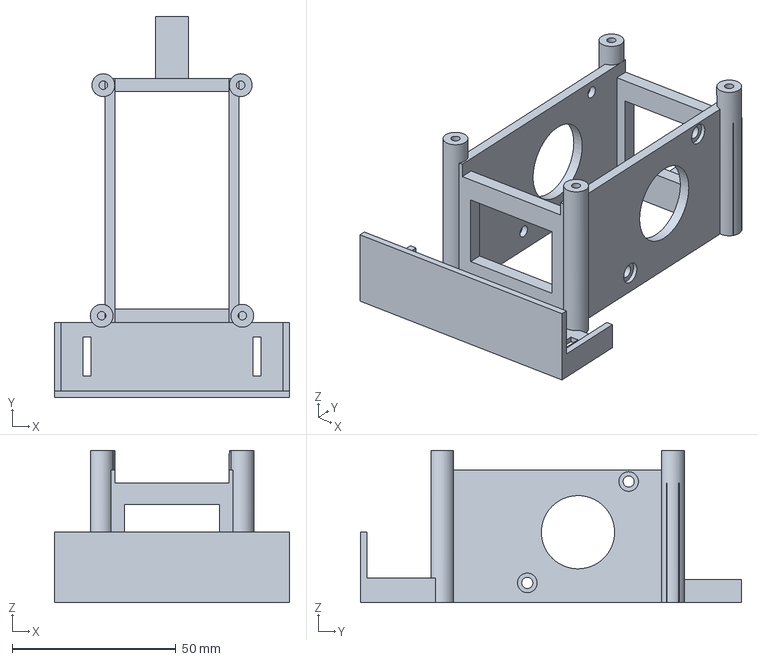
[picture p10: CAD file, 2026-11-10]
mechanical/cad/chassis.step
72.0 x 116.5 x 46.5 mm
