Tokoro0917/Mice-Standard/(list of files, cad)

Other CAD files:
mechanical/stl/chassis.stl
