Tokoro0917/Mice-Standard/docs/soldering/README.md

# はんだ付け

基板はサークルで発注済みのものを使います。ここでは部品の実装手順を説明します。

- 必要な工具
- **電池のケーブルに XT30 をはんだ付けするときは極性（+ / −）を必ず確認する**（逆接続保護がないため）
- **NUCLEO-L432KC の改造: SB16 と SB18 のはんだブリッジを外す**（表示 LED 用。詳細は [ピン割り当て](../pin-assignment.md)）
- 実装の順番（背の低い部品から）
- 部品表（BOM）: [`hardware/production/`](../../hardware/production/)
- 動作チェック（テスターでのショート確認など）

TBD
