Tokoro0917/Mice-Standard/docs/getting-started.md

# 開発環境の構築

プログラム初心者向けに、ファームウェアをビルドして書き込めるようになるまでの手順をまとめます。

## 必要なもの

- [STM32CubeMX](https://www.st.com/ja/development-tools/stm32cubemx.html)
- [Visual Studio Code](https://code.visualstudio.com/)
- VS Code 拡張機能「STM32Cube for Visual Studio Code」
- Git

## 手順

TBD
