Tokoro0917/Mice-Standard/docs/assembly/README.md

# 組み立て

はんだ付けが終わった基板に、モータ・タイヤなどの機構部品を取り付ける手順です。

TBD
