Tokoro0917/Mice-Standard/mechanical/cad/assembly-bottom.png

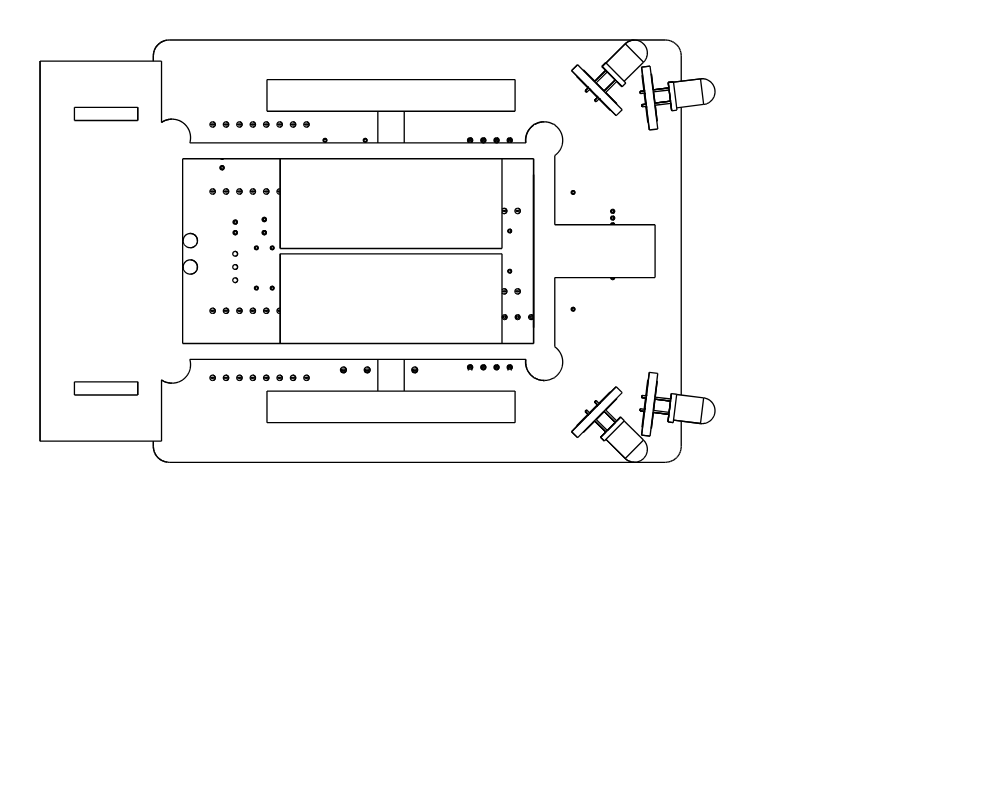
mechanical/cad/assembly-bottom.png
