Tokoro0917/Mice-Standard/mechanical/cad/assembly-front.png

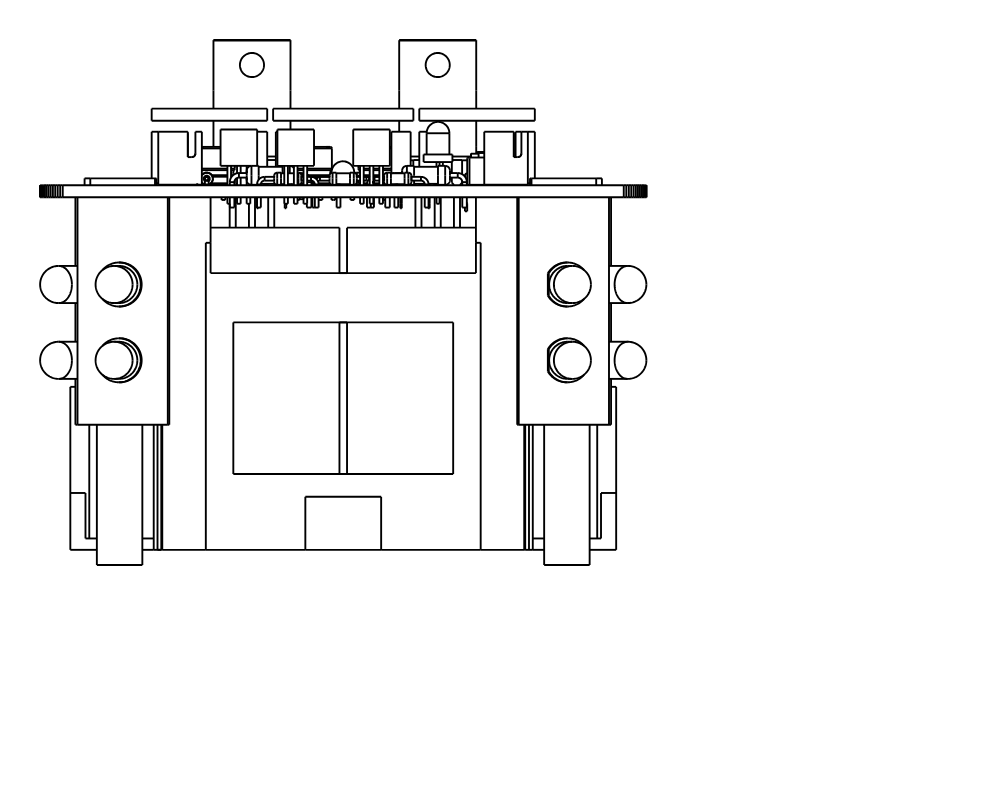
mechanical/cad/assembly-front.png
