Tokoro0917/Mice-Standard/mechanical/cad/assembly-iso.png

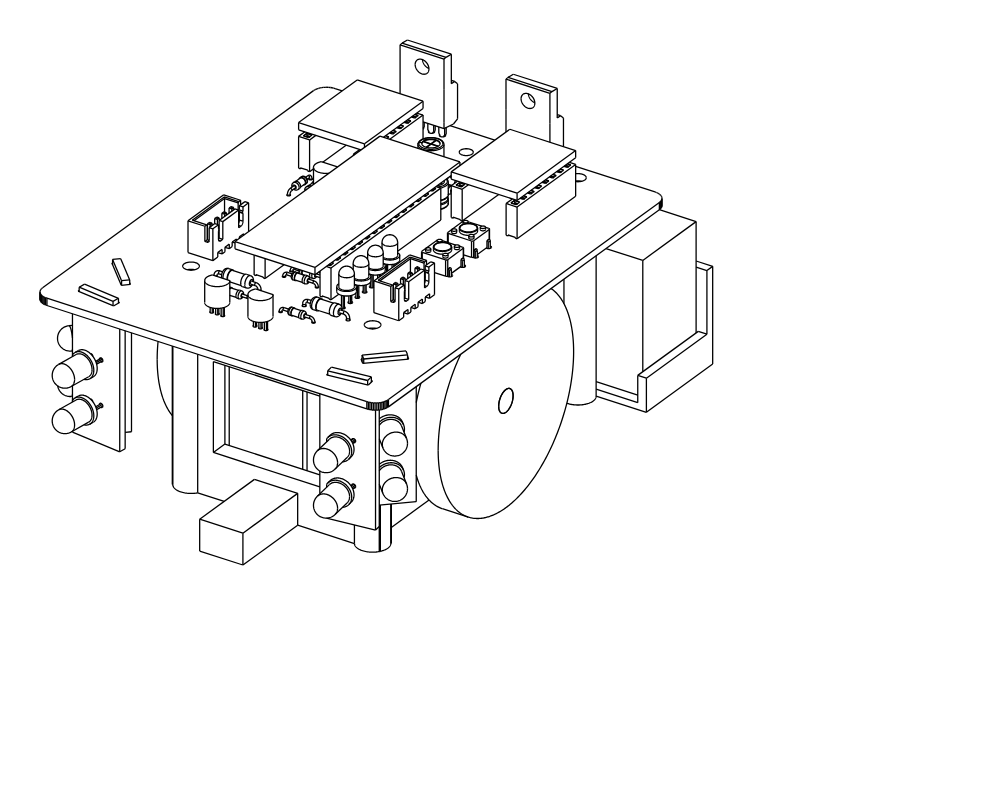
mechanical/cad/assembly-iso.png
