Tokoro0917/Mice-Standard/mechanical/cad/assembly-rear.png

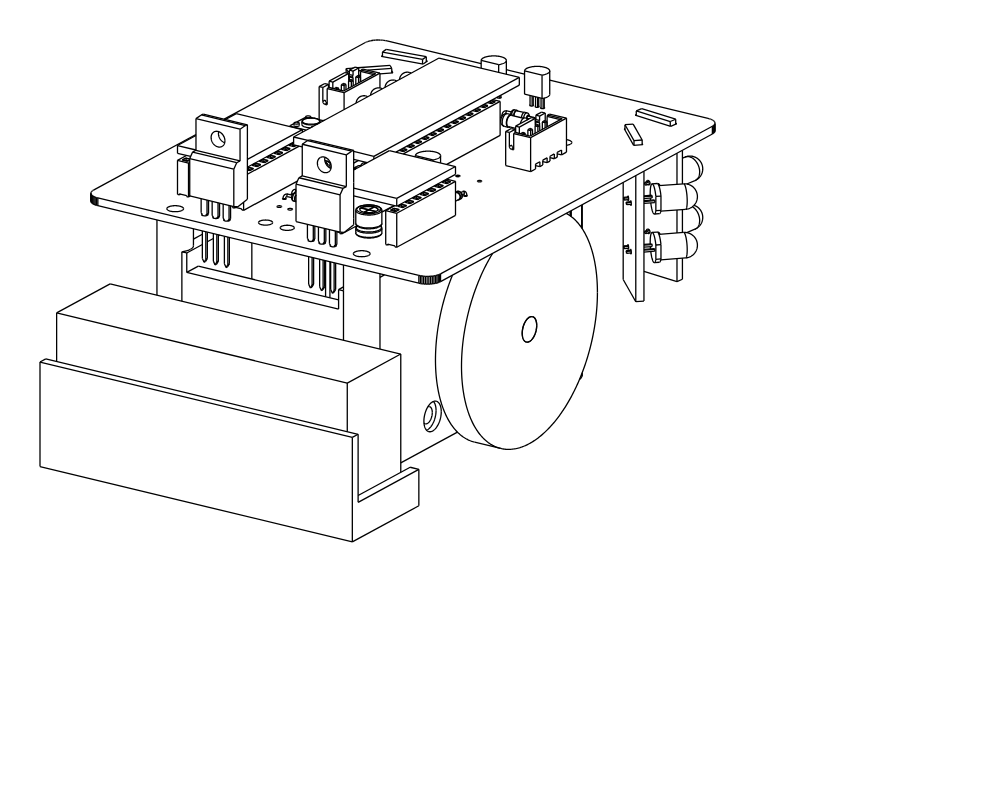
mechanical/cad/assembly-rear.png
