Tokoro0917/Mice-Standard/hardware/sensor-board/sensor-board.pdf

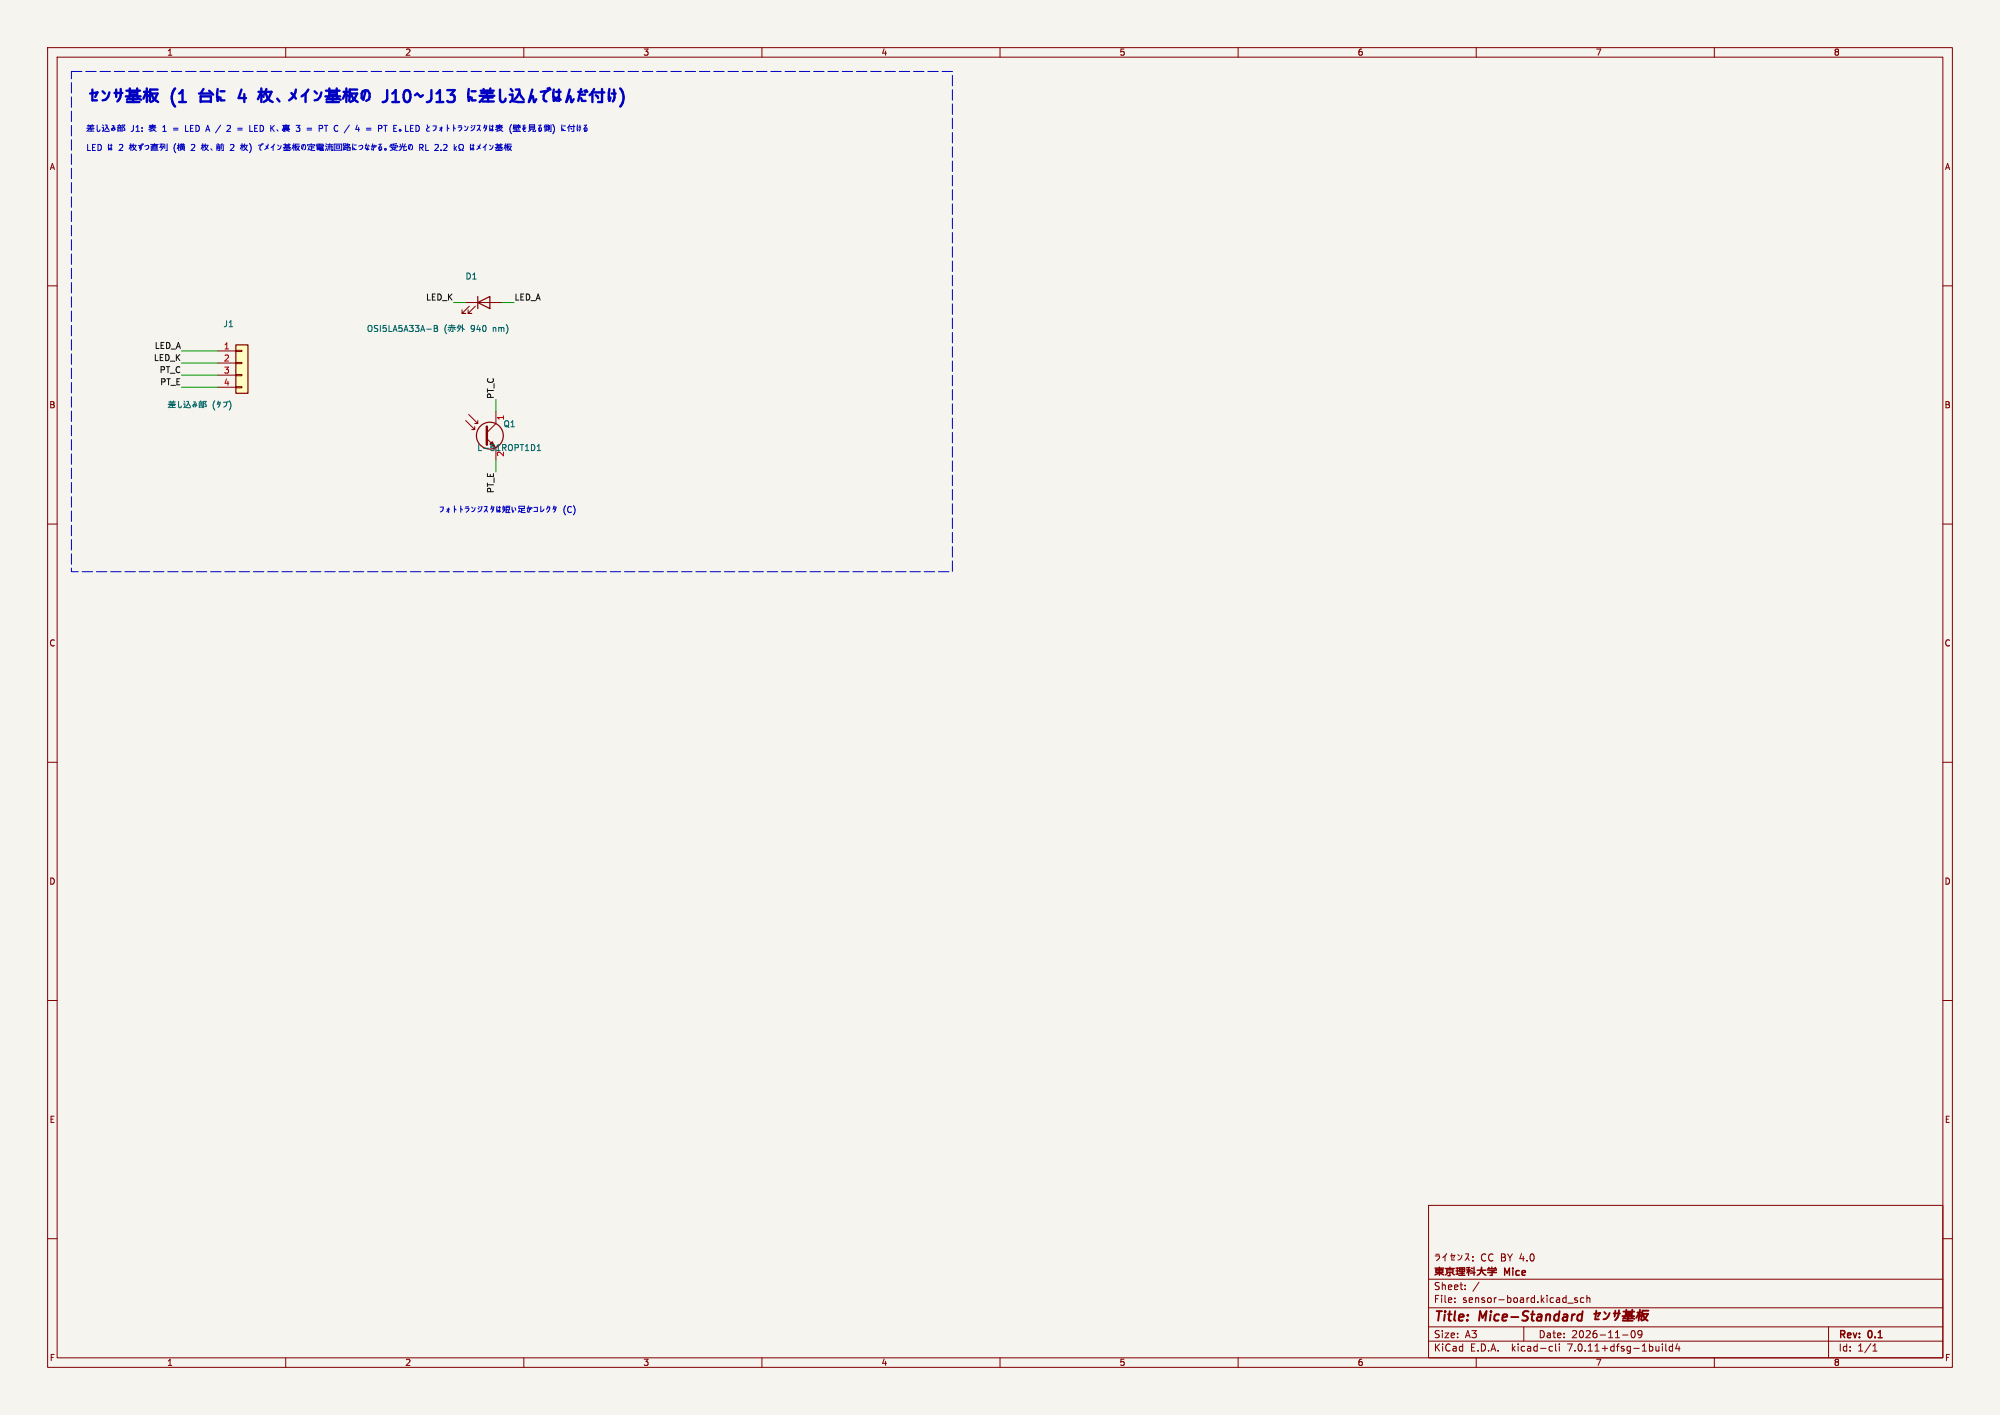
[picture p15: page 1]

þÿ]î0W•¼0••èJ1: þÿˆh1 = LED A / 2 = LED þÿK0ˆÏ3 = PT C / 4 = PT þÿE0-
