Tokoro0917/Mice-Standard/hardware/main-board/mice-standard.kicad_pcb

## KiCad design hardware/main-board/mice-standard.kicad_pcb (2026-11-10)

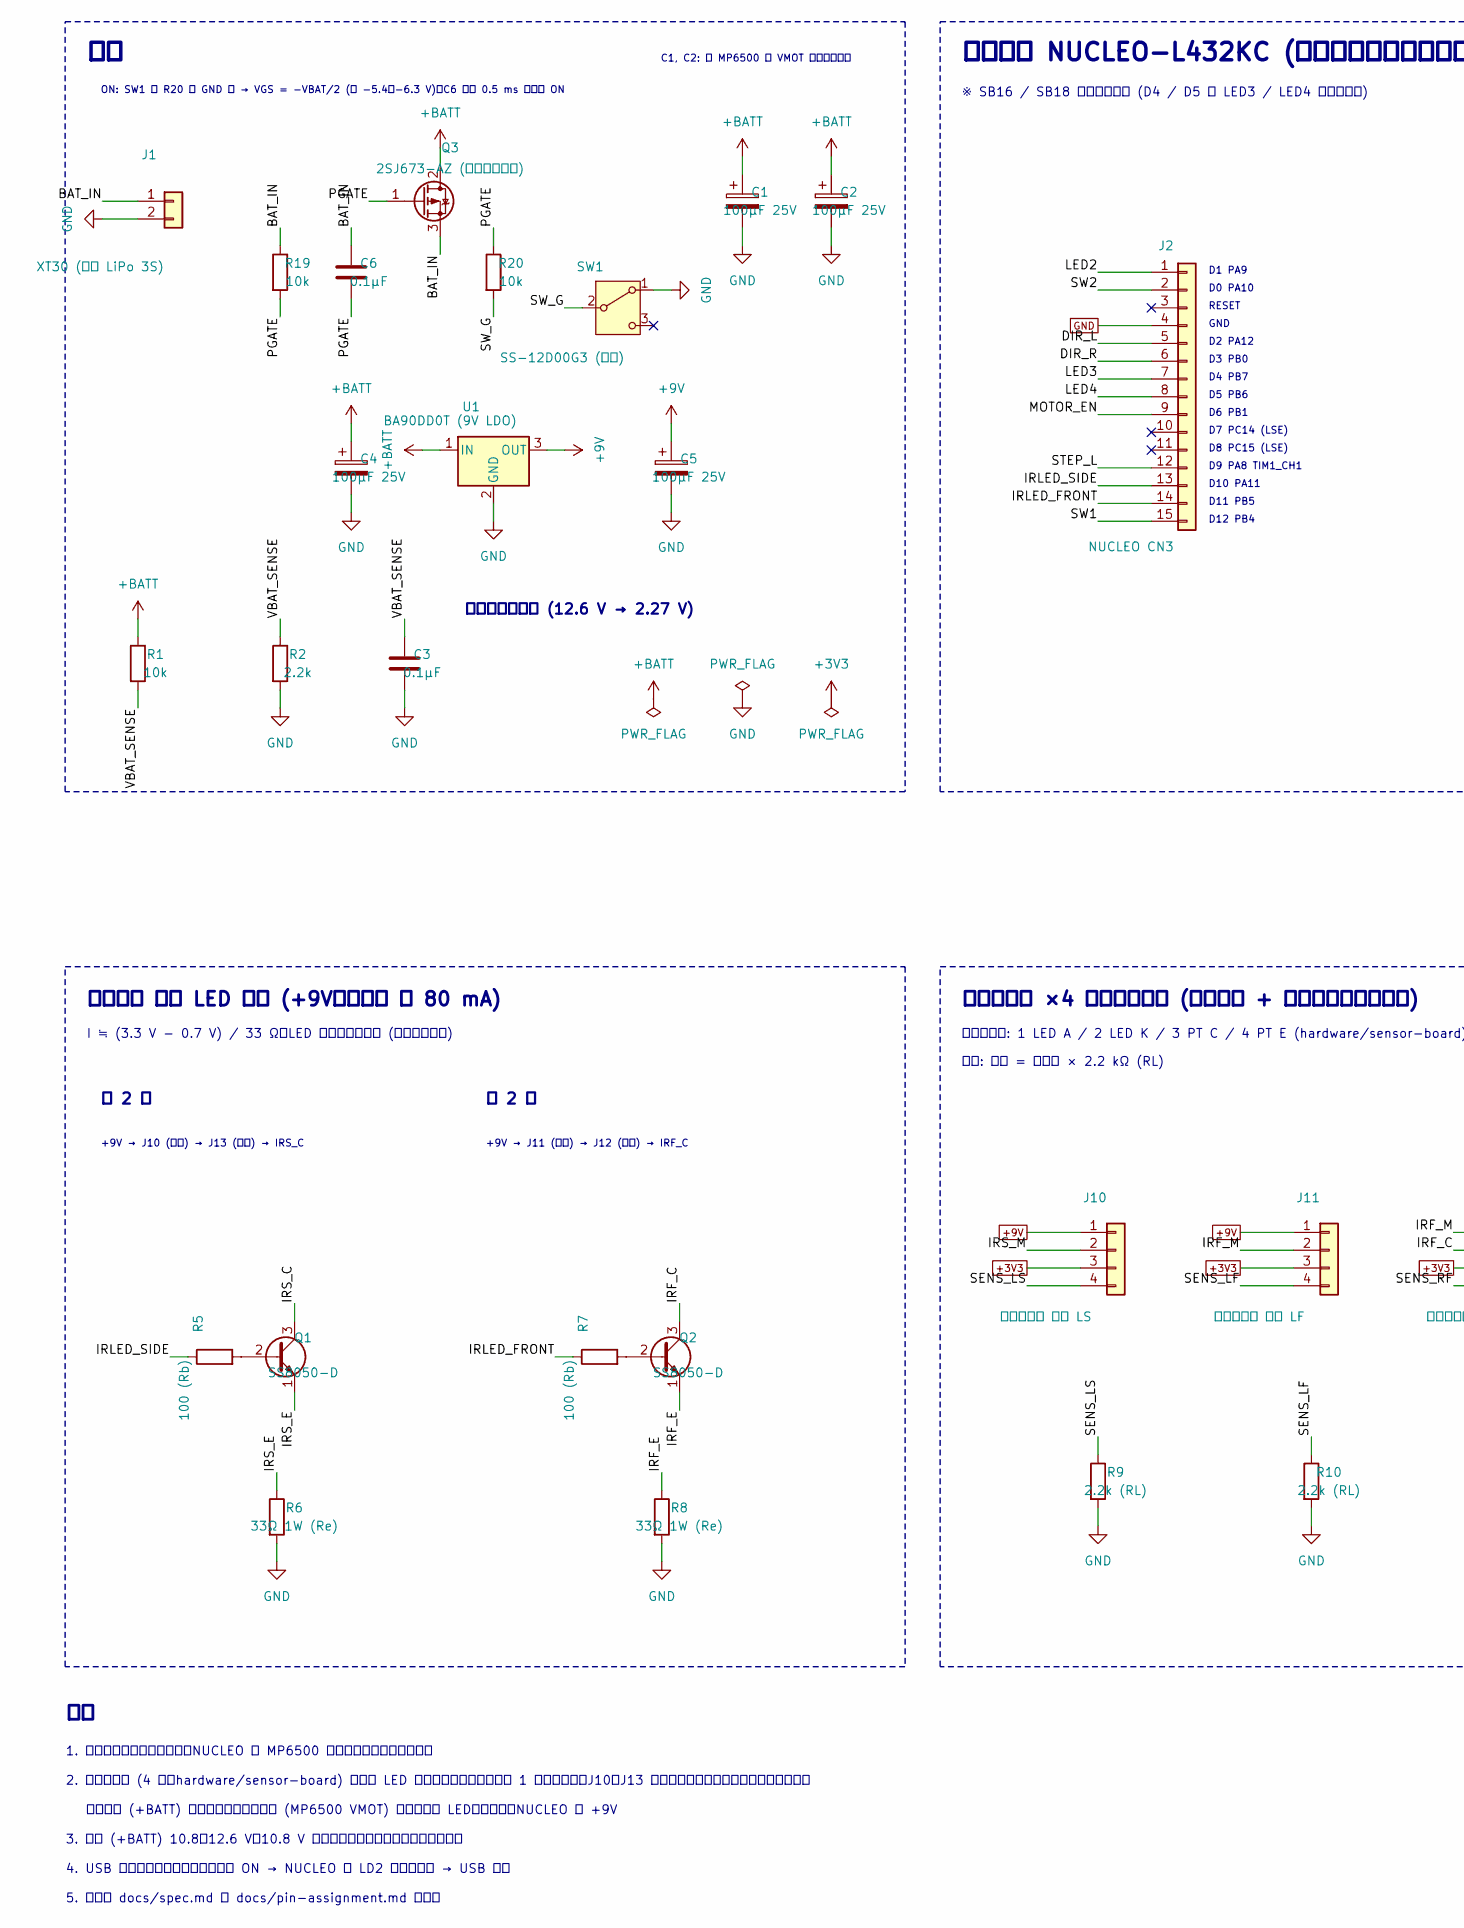
[picture p16: schematic mice-standard.kicad_sch, Mice-Standard 標準機 回路図, part in row 1, column 1]

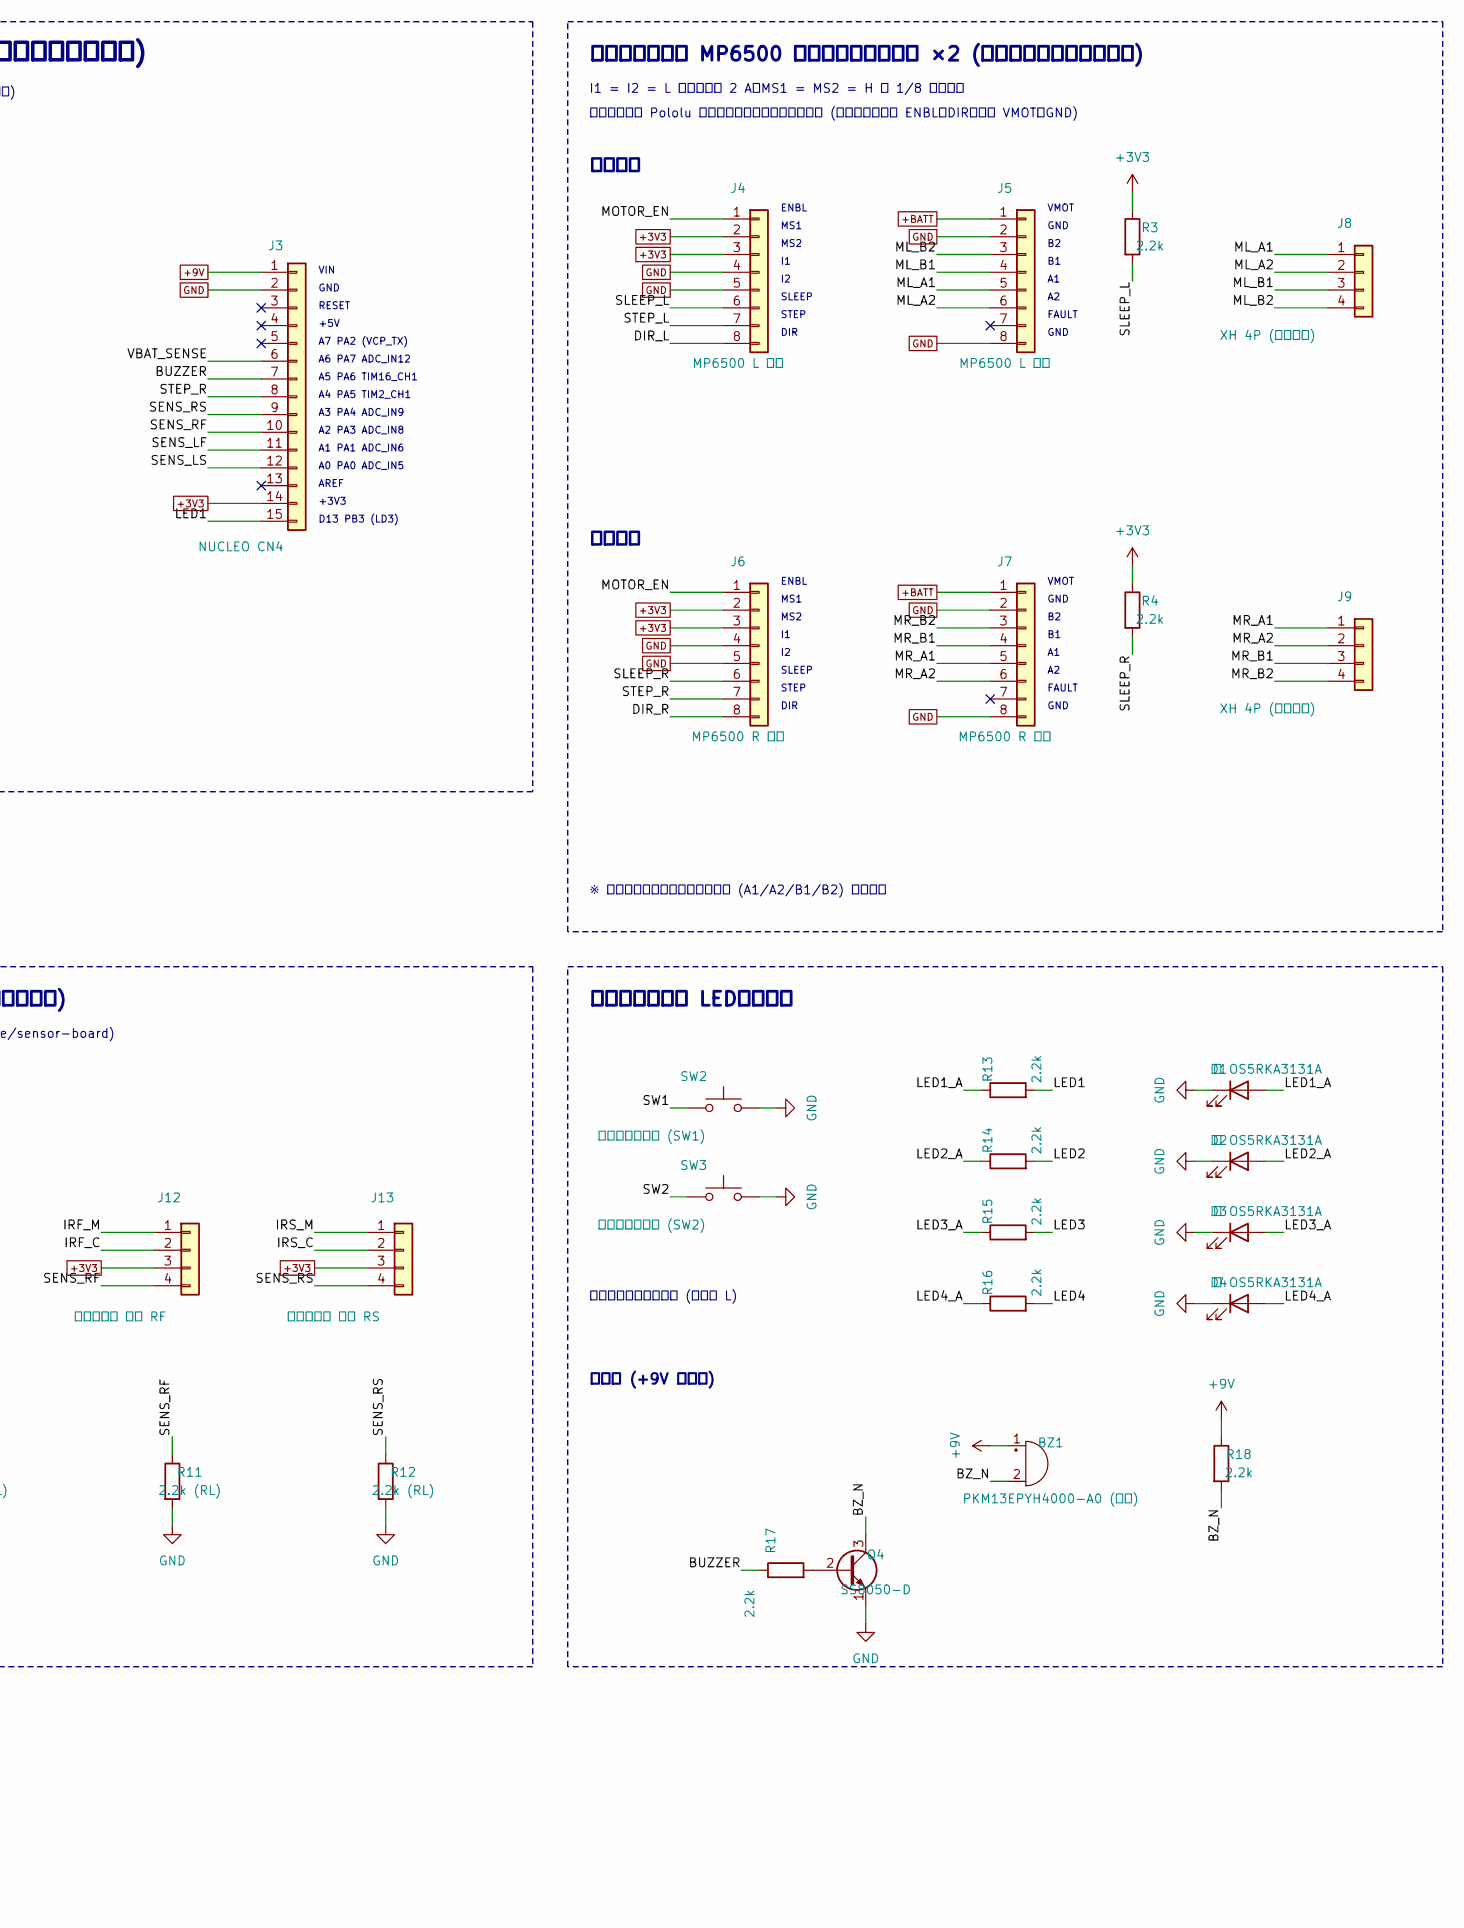
[picture p17: schematic mice-standard.kicad_sch, Mice-Standard 標準機 回路図, part in row 1, column 2]

Parts:
BZ1: PKM13EPYH4000-A0 (他励); Buzzer_Murata_PKM13EPYH4000
C1, C2, C4, C5: 100µF 25V; CP_Radial_D5.0mm_P2.00mm
C3, C6: 0.1µF; C_Disc_D3.0mm_W1.6mm_P2.50mm
D1, D2, D3, D4: 赤 OS5RKA3131A; LED_D3.0mm
J1: XT30 (電池 LiPo 3S); AMASS_XT30U-F_1x02_P5.0mm_Vertical
J2: NUCLEO CN3; PinSocket_1x15_P2.54mm_Vertical
J3: NUCLEO CN4; PinSocket_1x15_P2.54mm_Vertical
J4: MP6500 L 左列; PinSocket_1x08_P2.54mm_Vertical
J5: MP6500 L 右列; PinSocket_1x08_P2.54mm_Vertical
J6: MP6500 R 左列; PinSocket_1x08_P2.54mm_Vertical
J7: MP6500 R 右列; PinSocket_1x08_P2.54mm_Vertical
J8: XH 4P (左モータ); JST_XH_B4B-XH-A_1x04_P2.50mm_Vertical
J9: XH 4P (右モータ); JST_XH_B4B-XH-A_1x04_P2.50mm_Vertical
J10: センサ基板 左横 LS; SensorSlot_4P
J11: センサ基板 左前 LF; SensorSlot_4P
J12: センサ基板 右前 RF; SensorSlot_4P
J13: センサ基板 右横 RS; SensorSlot_4P
Q1, Q2, Q4: SS8050-D; TO-92_Inline
Q3: 2SJ673-AZ (電源スイッチ); TO-220F-3_Vertical
R1, R19, R20: 10k; R_Axial_DIN0204_L3.6mm_D1.6mm_P7.62mm_Horizontal
R2, R3, R4, R13, R14, R15, R16, R17, R18: 2.2k; R_Axial_DIN0204_L3.6mm_D1.6mm_P7.62mm_Horizontal
R5, R7: 100 (Rb); R_Axial_DIN0204_L3.6mm_D1.6mm_P7.62mm_Horizontal
R6, R8: 33Ω 1W (Re); R_Axial_DIN0207_L6.3mm_D2.5mm_P10.16mm_Horizontal
R9, R10, R11, R12: 2.2k (RL); R_Axial_DIN0204_L3.6mm_D1.6mm_P7.62mm_Horizontal
SW1: SS-12D00G3 (電源); SW_Slide_SS-12D00G3
SW2: タクトスイッチ (SW1); SW_PUSH_6mm
SW3: タクトスイッチ (SW2); SW_PUSH_6mm
U1: BA90DD0T (9V LDO); TO-220F-3_Vertical

Connections:
+3V3: J3.14, J4.2, J4.3, J6.2, J6.3, J10.3, J11.3, J12.3, J13.3, R3.1, R4.1
+9V: BZ1.1 (+), C5.1, J3.1, J10.1, J11.1, R18.1, U1.3 (OUT)
+BATT: C1.1, C2.1, C4.1, J5.1, J7.1, Q3.2 (D), R1.1, U1.1 (IN)
/BAT_IN: C6.1, J1.1, Q3.3 (S), R19.1
/BUZZER: J3.7, R17.1
/BZ_N: BZ1.2 (-), Q4.3 (C), R18.2
/DIR_L: J2.5, J4.8
/DIR_R: J2.6, J6.8
/IRF_C: J12.2, Q2.3 (C)
/IRF_E: Q2.1 (E), R8.1
/IRF_M: J11.2, J12.1
/IRLED_FRONT: J2.14, R7.1
/IRLED_SIDE: J2.13, R5.1
/IRS_C: J13.2, Q1.3 (C)
/IRS_E: Q1.1 (E), R6.1
/IRS_M: J10.2, J13.1
/LED1: J3.15, R13.2
/LED1_A: D1.2 (A), R13.1
/LED2: J2.1, R14.2
/LED2_A: D2.2 (A), R14.1
/LED3: J2.7, R15.2
/LED3_A: D3.2 (A), R15.1
/LED4: J2.8, R16.2
/LED4_A: D4.2 (A), R16.1
/ML_A1: J5.5, J8.1
/ML_A2: J5.6, J8.2
/ML_B1: J5.4, J8.3
/ML_B2: J5.3, J8.4
/MOTOR_EN: J2.9, J4.1, J6.1
/MR_A1: J7.5, J9.1
/MR_A2: J7.6, J9.2
/MR_B1: J7.4, J9.3
/MR_B2: J7.3, J9.4
/PGATE: C6.2, Q3.1 (G), R19.2, R20.1
/SENS_LF: J3.11, J11.4, R10.1
/SENS_LS: J3.12, J10.4, R9.1
/SENS_RF: J3.10, J12.4, R11.1
/SENS_RS: J3.9, J13.4, R12.1
/SLEEP_L: J4.6, R3.2
/SLEEP_R: J6.6, R4.2
/STEP_L: J2.12, J4.7
/STEP_R: J3.8, J6.7
/SW1: J2.15, SW2.1
/SW2: J2.2, SW3.1
/SW_G: R20.2, SW1.2 (B)
/VBAT_SENSE: C3.1, J3.6, R1.2, R2.1
GND: C1.2, C2.2, C3.2, C4.2, C5.2, D1.1 (K), D2.1 (K), D3.1 (K), D4.1 (K), J1.2, J2.4, J3.2, J4.4, J4.5, J5.2, J5.8, J6.4, J6.5, J7.2, J7.8, Q4.1 (E), R2.2, R6.2, R8.2, R9.2, R10.2, R11.2, R12.2, SW1.1 (A), SW2.2, SW3.2, U1.2 (GND)
unnamed: Q1.2 (B), R5.2
unnamed: Q2.2 (B), R7.2
unnamed: Q4.2 (B), R17.2

Notes on the sheet:
ON: SW1 で R20 を GND へ → VGS = −VBAT/2 (約 −5.4〜−6.3 V)。C6 で約 0.5 ms かけて ON
C1, C2: 各 MP6500 の VMOT の近くに置く
電池電圧の分圧 (12.6 V → 2.27 V)
マイコン NUCLEO-L432KC (ピンソケットに差し込み)
※ SB16 / SB18 を外して使う (D4 / D5 を LED3 / LED4 に使うため)
D1 PA9
D0 PA10
RESET
GND
D2 PA12
D3 PB0
D4 PB7
D5 PB6
D6 PB1
D7 PC14 (LSE)
D8 PC15 (LSE)
D9 PA8 TIM1_CH1
D10 PA11
D11 PB5
D12 PB4
VIN
+5V
A7 PA2 (VCP_TX)
A6 PA7 ADC_IN12
A5 PA6 TIM16_CH1
A4 PA5 TIM2_CH1
A3 PA4 ADC_IN9
A2 PA3 ADC_IN8
A1 PA1 ADC_IN6
A0 PA0 ADC_IN5
AREF
+3V3
D13 PB3 (LD3)
モータドライバ MP6500 デジタル電流制御版 ×2 (ピンソケットに差し込み)
I1 = I2 = L で電流制限 2 A。MS1 = MS2 = H で 1/8 ステップ
ピンの並びは Pololu の配線図・裏面写真で確認済み (上から見て左列 ENBL〜DIR、右列 VMOT〜GND)
左モータ
ENBL
VMOT
MS1
MS2
SLEEP
STEP
FAULT
DIR
右モータ
※ モータ線とコネクタのピン対応 (A1/A2/B1/B2) は要確認
壁センサ 赤外 LED 駆動 (+9V、定電流 約 80 mA)
I ≒ (3.3 V − 0.7 V) / 33 Ω。LED はセンサ基板上 (右のブロック)
横 2 個
+9V → J10 (左横) → J13 (右横) → IRS_C
前 2 個
+9V → J11 (左前) → J12 (右前) → IRF_C
センサ基板 ×4 の差し込み口 (スリット + パッド、はんだ付け)
センサ基板: 1 LED A / 2 LED K / 3 PT C / 4 PT E (hardware/sensor-board)
受光: 出力 = 光電流 × 2.2 kΩ (RL)
スイッチ・表示 LED・ブザー
内蔵プルアップを使う (押すと L)
ブザー (+9V で駆動)
1. 表面実装部品は使わない。NUCLEO と MP6500 はピンソケットに差し込む
2. センサ基板 (4 枚、hardware/sensor-board) に赤外 LED とフォトトランジスタを 1 組ずつ載せ、J10〜J13 のスリットに差し込んではんだ付けする
電池電圧 (+BATT) を直接使うのはモータ (MP6500 VMOT) のみ。赤外 LED・ブザー・NUCLEO は +9V
3. 電池 (+BATT) 10.8〜12.6 V。10.8 V でファームウェアが警告して停止する
4. USB をつなぐときは電池スイッチ ON → NUCLEO の LD2 点灯を確認 → USB の順
5. 詳細は docs/spec.md と docs/pin-assignment.md を参照

Board: 2 copper layers, 56 parts (0 on the bottom side), 50 nets, no tracks yet.

Other parts of the board:
H1, H2, H3, H4: M3; MountingHole_3.2mm_M3
