Tokoro0917/Mice-Standard/hardware/sensor-board/sensor-board.kicad_pcb

## KiCad design hardware/sensor-board/sensor-board.kicad_pcb (2026-11-09)

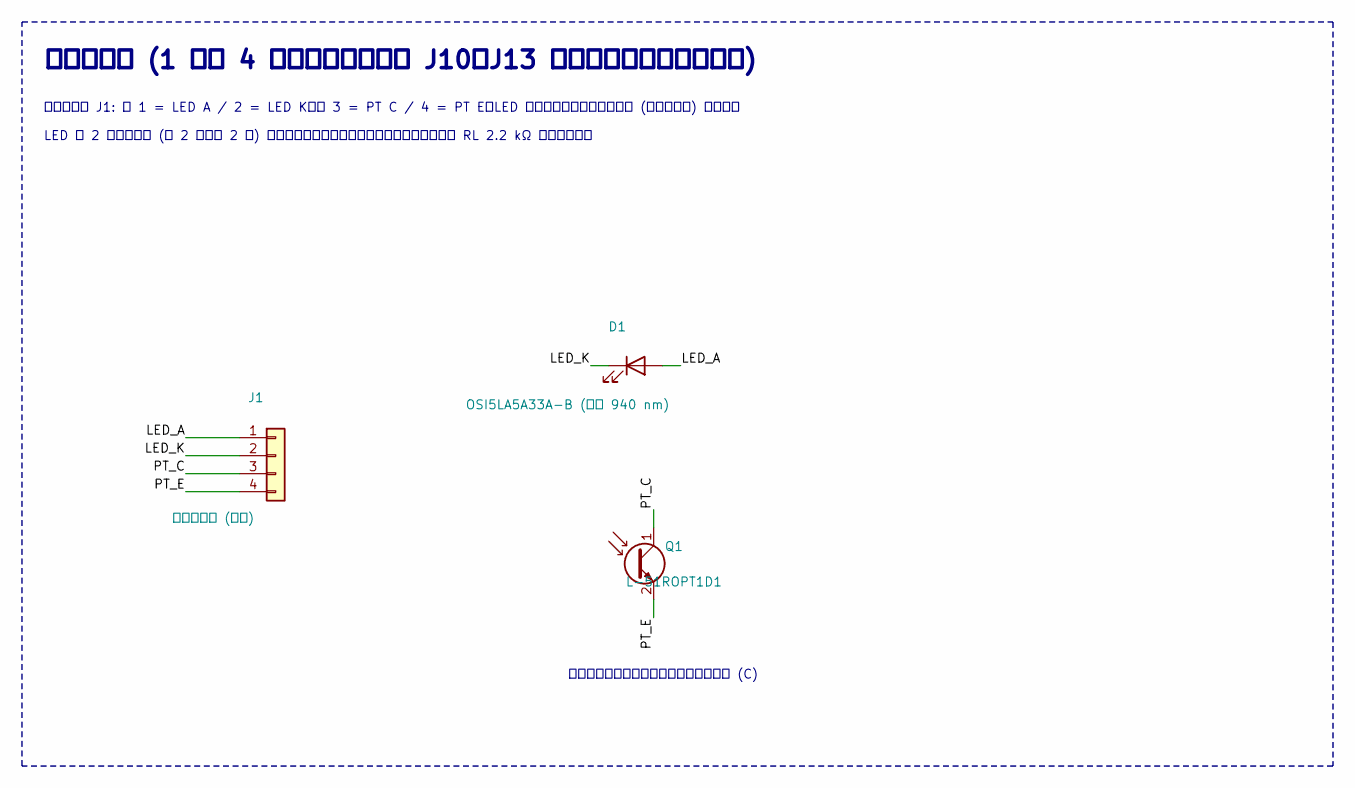
[picture p18: schematic sensor-board.kicad_sch, Mice-Standard センサ基板]

Parts:
D1: OSI5LA5A33A-B (赤外 940 nm); LED_D5.0mm
J1: 差し込み部 (タブ); SensorTab_4P
Q1: L-51ROPT1D1; LED_D5.0mm

Connections:
/LED_A: D1.2 (A), J1.1
/LED_K: D1.1 (K), J1.2
/PT_C: J1.3, Q1.1 (C)
/PT_E: J1.4, Q1.2 (E)

Notes on the sheet:
センサ基板 (1 台に 4 枚、メイン基板の J10〜J13 に差し込んではんだ付け)
差し込み部 J1: 表 1 = LED A / 2 = LED K、裏 3 = PT C / 4 = PT E。LED とフォトトランジスタは表 (壁を見る側) に付ける
LED は 2 枚ずつ直列 (横 2 枚、前 2 枚) でメイン基板の定電流回路につながる。受光の RL 2.2 kΩ はメイン基板
フォトトランジスタは短い足がコレクタ (C)

Board: 2 copper layers, 3 parts (0 on the bottom side), 4 nets, no tracks yet.
