Tokoro0917/Mice-Standard/(commit log)

2026-11-09 標準機リポジトリのディレクトリ構成を追加
    hardware(KiCad)、mechanical(Fusion 360)、firmware(STM32CubeMX + VS Code)、
    docs、tools の雛形と各ディレクトリの README、.gitignore を追加。
    Claude-Session: https://claude.ai/code/session_01H2ZvpqvkPP9w5WBxsjqPHU
2026-11-09 ライセンスを追加（プログラムは MIT、基板・機構・文書は CC BY 4.0）
    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
2026-11-09 仕様書 docs/spec.md を追加（ステッピングモータ PKP242D23A2、SMD なし）
    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
2026-11-09 機構部品を 3D プリントで製作する方針を仕様書に追加
    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
2026-11-09 3D プリンタを Bambu Lab、材料を PLA に決定
    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
2026-11-09 モータ PKP242D23A2 の仕様と機体寸法の概算を仕様書に追加
    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
2026-11-09 モータは提供品のため費用なしと追記
    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
2026-11-09 壁センサをセンサ基板に分け、メイン基板に垂直に取り付ける構成を追加
    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
2026-11-09 センサ基板をセンサ 1 組ごとに分け、メイン基板に差し込んではんだ付けする構成に変更
    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
2026-11-09 マイコンを NUCLEO-L432KC（サークルで使用実績あり）に決定
    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
2026-11-09 電子部品を秋月電子で手に入るものに置き換え
    モータドライバ STSPIN220、赤外 LED OSI5LA5A33A-B、フォトトランジスタ
    L-51ROPT1D1、DC-DC BP5293-50 に決定。電池電圧の下限と外乱光対策を追記。
    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
2026-11-09 モータドライバを MP6500 に変更（脱調防止のため定格付近の電流で駆動）
    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
2026-11-09 電池を LiPo 3 セルに変更し、モータドライバソケットの互換表を追加
    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
2026-11-09 モータドライバを MP6500 専用の接続に決定
    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
2026-11-09 NUCLEO-L432KC のピン割り当て表（案）を追加
    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
2026-11-09 UM1956 でピンの制約と電源条件を確認し、ピン割り当て表に反映
    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
2026-11-09 電源構成を決定: 電池からダイオード 2 本で NUCLEO の VIN に給電、5 V DC-DC を廃止
    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
2026-11-09 赤外 LED の駆動回路（定電流回路、約 95 mA）の案を仕様書に追加
    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
2026-11-09 受光回路（エミッタフォロワ、RL 1 kΩ）の案を仕様書に追加
    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
2026-11-09 受光回路の RL を 2.2 kΩ に決定し、電源・分圧・スイッチ・LED・ブザーの回路案を追加
    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
2026-11-09 表示 LED を 4 個に変更（NUCLEO の SB16 / SB18 を外して PB6 / PB7 を使用）
    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
2026-11-09 部品表 bom.csv（v0.1）を追加
    秋月電子を中心に品番・価格を調査。モータ接続は XH 4P に決定。
    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
    [bom.csv]
2026-11-09 MP6500 をデジタル電流制御版（RobotShop）に変更、I1/I2 を GND に固定して 2 A。ヒートシンクは後回し
    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
    [bom.csv]
2026-11-09 壁センサを赤色 LED（OS5RKA5111A）+ 可視光フォトトランジスタ（NJL7502L）に変更
    LED 電流 55 mA、受光 RL 4.7 kΩ（初期値）に再設計。
    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
    [bom.csv]
2026-11-09 README の壁センサ表記を赤色 LED に更新
    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
2026-11-09 Revert "README の壁センサ表記を赤色 LED に更新"
    This reverts commit 4cc868088b8c2a2e9be95396eeacaac7c2bf4594.
2026-11-09 Revert "壁センサを赤色 LED（OS5RKA5111A）+ 可視光フォトトランジスタ（NJL7502L）に変更"
    This reverts commit 9025a41e31f7f53651800ee59aa25daf3efbbafc.
    [bom.csv]
2026-11-09 赤外 LED の Re を 33 Ω（E6 系列）に変更し、LED 電流を約 80 mA に
    Rc と同じ 33 Ω 1 W に統一。抵抗は E6 系列の値のみ使う方針を追記。
    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
    [bom.csv]
2026-11-09 回路図 v0.1 を追加（KiCad、A3 1 枚）
    メイン基板とセンサ基板の全部品を 1 枚に収録。PDF も同梱。
    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
    [mice-standard.kicad_sch]
2026-11-09 電源回路を変更: P-ch MOSFET で逆接続保護、9 V LDO（BA09CC0T）で NUCLEO の VIN に給電
    ダイオード 2 本で電圧を下げる方式を廃止。回路図・仕様書・部品表を更新。
    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
    [bom.csv, mice-standard.kicad_sch]
2026-11-09 電源部品を秋月で最も性能のよいものに変更: 2SJ673-AZ、BA90DD0T、22 µF 35V（ニチコン PC）
    データシートで仕様を確認。部品選定の方針（秋月で最高性能）を仕様書に追記。
    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
    [bom.csv, mice-standard.kicad_sch]
2026-11-09 仕様書の LDO 表記の残りを BA90DD0T に修正
    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
2026-11-09 赤外 LED・ブザーを +9V 駆動にし、部品の種類を整理
    - 電池電圧を直接使うのはモータのみ。赤外 LED（Rc を廃止）とブザー（トランジスタ駆動）は +9V
    - 抵抗を金属皮膜 ±1% の 4 種類（33Ω 1W / 100Ω / 2.2kΩ / 10kΩ）に統一
    - コンデンサを 100µF（Rubycon PX）と 0.1µF の 2 種類に統一
    - ヒューズを遮断容量の大きい RGEF300 に、ピンソケットを分割ロング品 1 種類に
    - 回路図・仕様書・部品表を更新
    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
    [bom.csv, mice-standard.kicad_sch]
2026-11-09 電源スイッチを KOGUMA-Mk4 と同じ P-ch MOSFET 方式に変更し、ヒューズを廃止
    - 2SJ673-AZ をスイッチの向きで使い、スライドスイッチでゲートを切り替える（ゆっくり ON）
    - ヒューズ・ツェナー・トグルスイッチを削除。ゲートの部品は既存の 10kΩ・0.1µF を使用
    - 逆接続保護がないため、XT30 の極性確認を手順書に追記
    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
    [bom.csv, mice-standard.kicad_sch]
2026-11-09 MP6500 のピン配置を Pololu の配線図・裏面写真で確認し、仕様書と回路図に反映
    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
    [mice-standard.kicad_sch]
2026-11-09 回路図の全部品にフットプリントを割り当て
    スライドスイッチと圧電サウンダは自作フットプリント（Mice-Standard ライブラリ）を後で作る。
    2SJ673 のピン順（G-D-S）はデータシートの外形図で確認。
    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
    [mice-standard.kicad_sch]
2026-11-09 基板設計を開始: メイン基板の外形と部品配置、センサ基板、自作フットプリント
    - メイン基板 50x100 mm: 外形・取付穴・全部品の初期配置（重なりなし）、ネット付き。配線は未着手
    - センサ基板を別プロジェクト化（LED + フォトトランジスタ + 差し込み部）。回路図はメイン基板側を差し込み口 J10〜J13 に変更
    - 自作フットプリント: センサのスリット・タブ、スライドスイッチ、圧電サウンダ
    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
    [mice-standard.kicad_pcb, mice-standard.kicad_sch, sensor-board.kicad_pcb, sensor-board.kicad_sch]
2026-11-09 回路図 PDF を更新し、メイン基板の配置図を追加
    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
2026-11-09 機体全体の STEP を追加（メイン基板・センサ基板・モータ・ホイール）
    - メイン基板とセンサ基板の STEP を KiCad から出力（部品の 3D モデル付き）
    - CadQuery で組み立てた参考モデルとプレビュー画像を mechanical/cad/ に追加
    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
    [mice-standard-assembly.step, mice-standard.step, sensor-board.step]
2026-11-09 機体全体の STEP を作り直すスクリプトを追加
    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
2026-11-09 シャーシを追加（3D プリント PLA 一体成形）と全体 STEP の更新
    - モータ取付壁 x2、前後のはり、基板を留めるボス x4、すべり材 x2
    - メイン基板の下面を 50 mm に上げ、部品の足とモータ・はりの間を確保
    - CadQuery のスクリプト、STEP、印刷用 STL、プレビュー画像
    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
    [chassis.step, chassis.stl, mice-standard-assembly.step]
2026-11-09 車高を 2.5 mm に（ホイール径 47 mm）。シャーシと全体の STEP を更新
    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
    [chassis.step, chassis.stl, mice-standard-assembly.step]
2026-11-09 壁センサを KOGUMA-Mk4 と同じ考え方で配置し、基板を幅 68 mm に。シャーシを前後に伸ばしカグスベールの接地点に
    - メイン基板 v0.2: ホイールの上まで広げ、前センサを一番外側（外へ 7°）、横センサを交差（反対側の前の柱を見る）に
    - MP6500 を NUCLEO 本体と重ならない位置へ
    - シャーシ: 前後に腕を伸ばし、カグスベールを貼る台（床とのすき間 0.5 mm）
    - 全体の STEP・図を更新し、部品どうしの干渉がないことを確認
    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
    [bom.csv, chassis.step, chassis.stl, mice-standard-assembly.step, mice-standard.kicad_pcb, mice-standard.step]
2026-11-09 横の壁センサを交差させない配置に変更
    外側・前センサの少し後ろに置き、自分の側の前の柱を見る（前から外へ 46.3°）。
    全体モデルで干渉なし、LED と受光の正面が遮られないことを確認。
    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
    [mice-standard-assembly.step, mice-standard.kicad_pcb, mice-standard.step]
2026-11-10 電池（Zeee 3S 850 mAh）を機体の後ろに立てて載せる台をシャーシに追加
    - 寝かせるとその場旋回で壁に当たるため、長い辺を左右にして立てる（旋回半径 約 76 mm）
    - シャーシの下面を 2.0 mm の平面にそろえ、立てたまま印刷できる形に。後ろの接地点は電池の台の下
    - 全体の STEP・図、重心の見積もり、仕様書・部品表を更新
    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
    [bom.csv, chassis.step, chassis.stl, mice-standard-assembly.step]
2026-11-10 車幅を 80 mm に: メイン基板を 80 x 100 mm に広げ、壁センサを外側へ
    - 前センサ (∓29, 49) 外へ 7°、横センサ (∓30.5, 39) 前から外へ 44.7°。LED の先まで車幅 80 mm 以内
    - 全体の STEP・図を更新し、干渉と光の遮りがないことを確認
    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
    [mice-standard-assembly.step, mice-standard.kicad_pcb, mice-standard.step]
2026-11-10 機構の README を車幅 80 mm に合わせて更新
    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
2026-11-10 機体全体の色付きの図（迷路の区画に置いたところ）を追加
    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
